hkn55/Kriko-/Hakan Aktaş 18065037 ScrewJackDesignnew.pdf

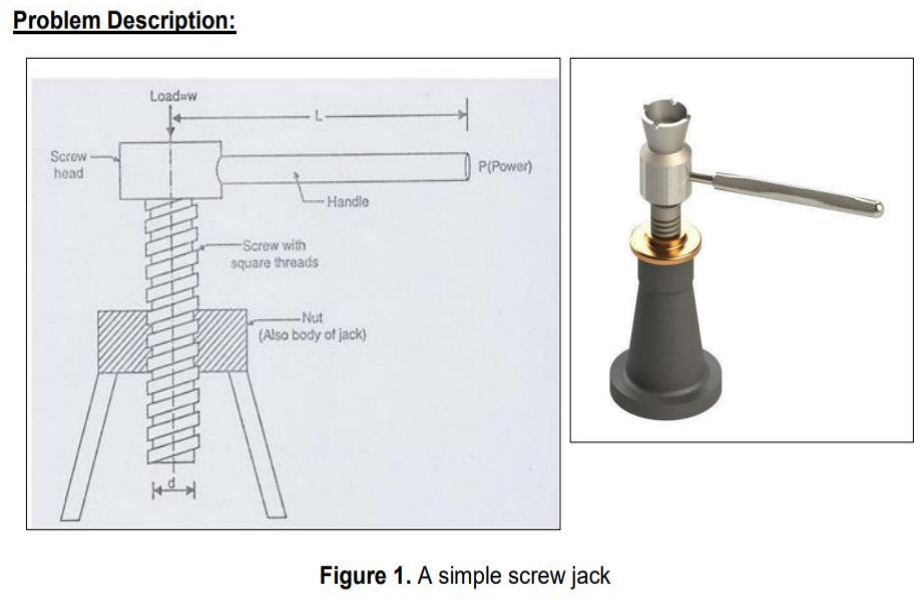
[picture p1: figure]

1-Definition and Mission of Screwjack

Screwjack: a screw-operated jack for lifting, exerting pressure, or adjusting position (as of a machine part).

Even by looking the definition we can figure out the mission of the screwjack.We are using screwjack in order to lift or adjusting the position of any kind of object has.So how this happens ?

The force which we imply on the handle creates a moment and by contribution of this moment a rotating motion occurs.For now these are the general knowledgements that we have to know about screwjack.

2-Assumptions and Values

S = Safety Factor = 2.5 ,

∅ = angle caused by friction between the nut and screw

μs = friction coefficitient between nut and screw = 0.15

tan−1
(us

) = ∅ ≅ 8.5308° ,

p = pitch of screw thread = 3mm
α = helix angle of screw(degree) α = tan−1 (

ρ
πdm

) , dm = (dc+d0)/2 ,

*Lead and pitch for two screw threads; one with one start and one with two starts.
Lead and pitch are closely related concepts. They can be confused because they are the same for most screws. Lead is the distance along the screw’s axis that is covered by one complete rotation of the screw (360°). Pitch is the distance from the crest of one thread to the next. Because the vast majority of screw threadforms are single-start threadforms, their lead and pitch are the same. Single-start means that there is only one “ridge” wrapped around the cylinder of the screw’s body. Each time that the screw’s body rotates one turn (360°), it has advanced axially by the width of one ridge. “Double-start” means that there are two “ridges” wrapped around the cylinder of the screw’s body. Each time that the screw’s body rotates one turn (360°), it has advanced axially by the width of two ridges.

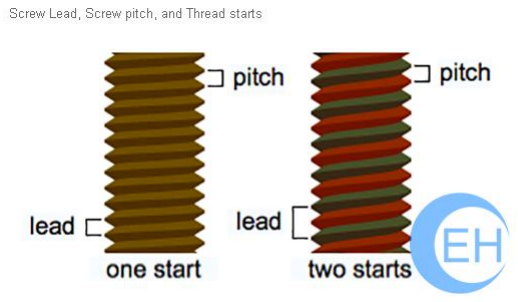
[picture p2: figure]

T1 = Torque required to rotate the screw = W tan(∅ + α)

dm
2

dc = core diameter of screw → d0 = outer diameter of screw = dc + p

W = longitudinal force = (1 + 8) ∗ 1000 = 9000 N

The screw part is made of St 60-2 steel , the nut part is made of St 50-2 steel and the handle is made of St 44-2 steel (Because screw is the most important material for this system.As for other parts it is assumed that they are made of St 37-2 material.

*We will assume that limits for tensile and compression stresses are equal.And also we will not modify yield stresses because we're assuming that diameters are small enough.

*Our analysis about safety of screwjack is terminated.This system is theoretically safe but it’s significant that to consider when it comes manufacturing there are some standarts that we have to obey.Since these materials are not standart elements i have disregarded the manufacturing standarts in this project.

3-Design of Screw

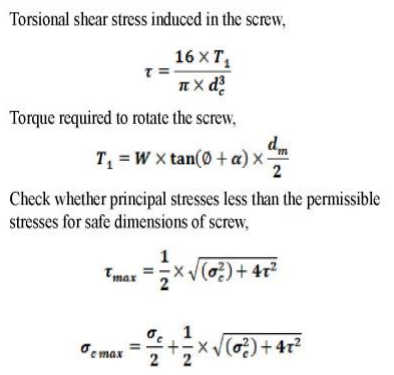
[picture p3: figure]
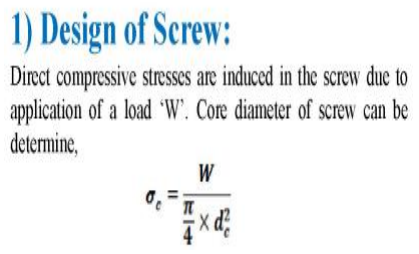
[picture p4: figure]

Befor

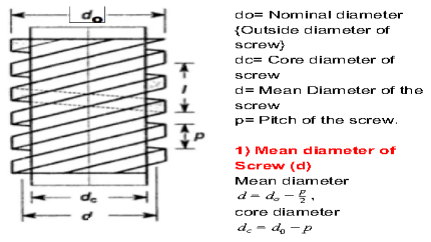
[picture p5: figure]

e doing the calculations firstly we have to devise our method about appropriate safety calculations.So for the inside part of screw we have 3 conditions:

1-Maximum shear stress , 2-Maximum tensile stress , 3-Analytical Method

We will start from analytical method and get a safe core diameter value.

(it's essential to start from the analytical method.First we have to determine safe core diameter variable according to the analytical method then test it for maximum stress theories.Let's start it.)

N/mm^2

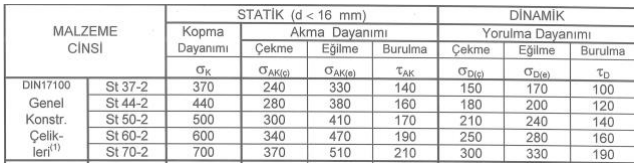
[picture p6: figure]

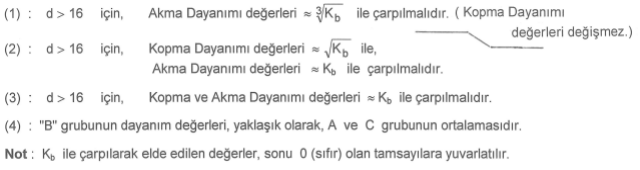
[picture p7: figure]
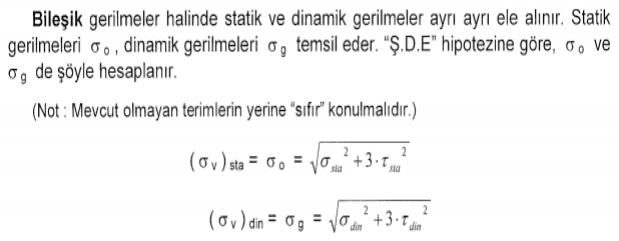
[picture p8: figure]

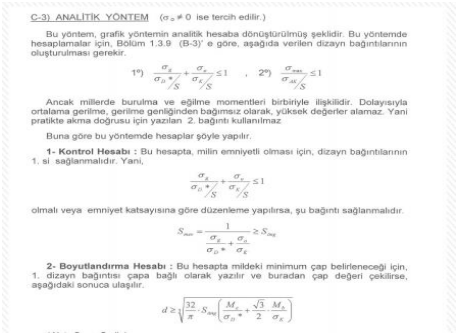
[picture p9: figure]

We don't need to modify the fracture stress.Because our material is in group 1.And since all stresses are static stresses we don't have to calculate σD

∗

Because that part of the equation will be equal to 0.
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
≤ 1 When we simplify this formula as a function of core

diameter we get

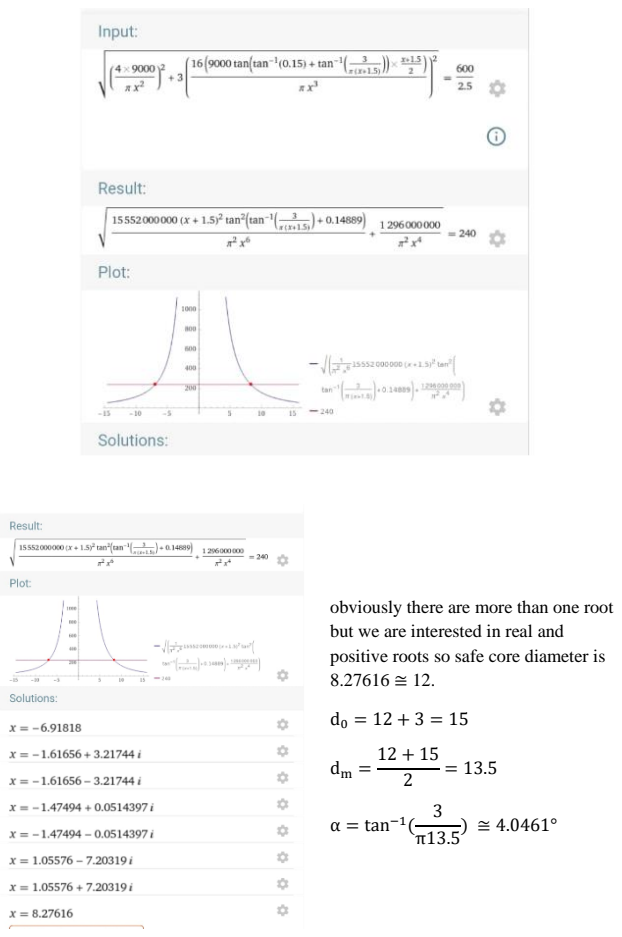
[picture p10: page 7]
α = tan−1

obviously there are more than one root
but we are interested in real and
positive roots so safe core diameter is

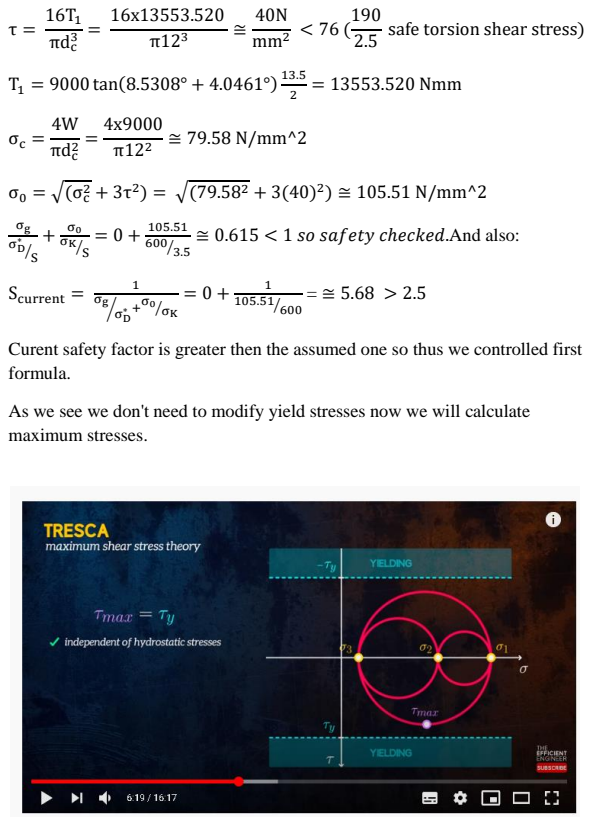
[picture p11: page 8]
safe torsion shear stress); T1 = 9000 tan(8.5308° + 4.0461°); = 13553.520 Nmm; ≅ 0.615 < 1 so safety cℎecked.And also:; Scurrent =

Curent safety factor is greater then the assumed one so thus we controlled first
formula.

As we see we don't need to modify yield stresses now we will calculate
maximum stresses.

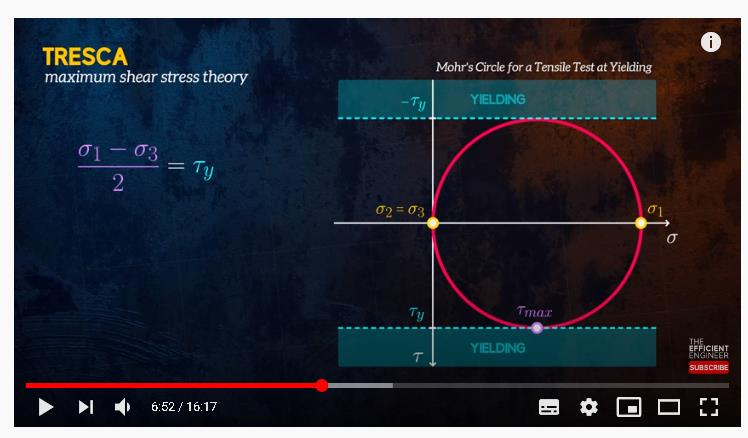
[picture p12: figure]

Tensile yield stress from the material table is represented as sigma1 in this example.And the yield shear stress equals to half of this value.(sigma2 and sigma 3 = 0. )

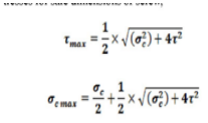
[picture p13: figure]

τmax = 0.5x√(79.582 + 4x402
) ≅ 56.42N/mm^2

σmax =

79.58
2

+ 0.5x√(79.582 + 4x402
)

≅ 96.21N/mm^2

now we will compare these maximum stresses with the yield stresses.

σtensileyield
S

=

340
2.5

= 136 > 96.21 safe

τyield
S

=

340
2x2.5

= 68 > 56.42 safe

4-Design of Nut

This part is a little bit confusing.We will try to understand stresses by using figures.

First let's start with bearing stress.Outside of screw and inside of nut are pressing each other during the load.So this situation creates a stress and it is called as bearing stress.

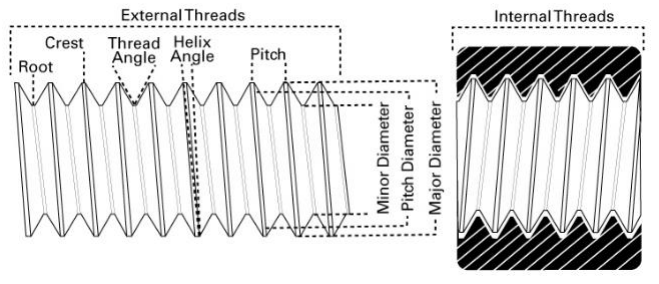
[picture p14: figure]

white trimmed black part is nut.In every single pitch screw is applying a pressure on that nut part.And the circumferance of the same part occurs a shear stress on the lateral area of nut.

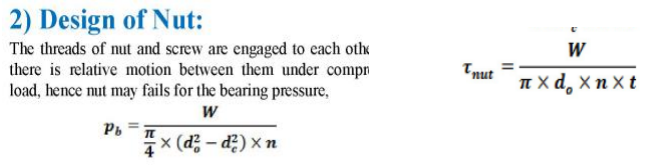
[picture p15: figure]

pb =

9000x4
π(152 − 122)n

, τnut =

9000
π15n1.5

n = number of threads engaged with the nut.Now we will execute the same maximum stresses principle.

t = thickness of screw = p/2

pb =

9000x4
π(152−122)n

≤

300
2.5

→ n ≥ 1.179 , τnut =

9000
π15n1.5

≤

300
2.5x2

→ n ≥ 2.12

*Material is subjected to these stresses separately

it seems that to take n as 5 is a proper choice for us.

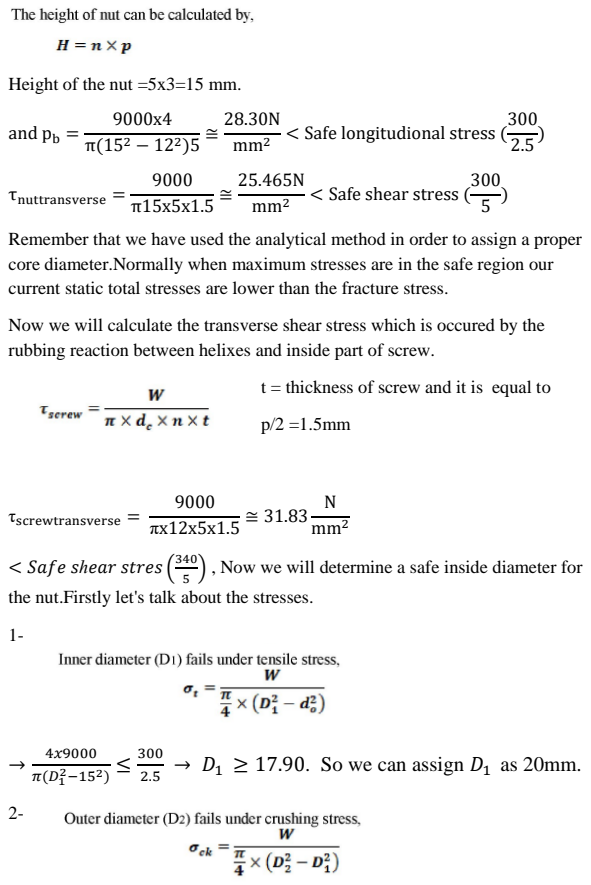
[picture p16: page 11]
and pb =; τnuttransverse =; < Safe shear stress (; τscrewtransverse =

Height of the nut =5x3=15 mm.

mm2 < Safe longitudional stress (

Remember that we have used the analytical method in order to assign a proper
core diameter.Normally when maximum stresses are in the safe region our
current static total stresses are lower than the fracture stress.

Now we will calculate the transverse shear stress which is occured by the
rubbing reaction between helixes and inside part of screw.

t = thickness of screw and it is equal to

< Safe sℎear stres (

) , Now we will determine a safe inside diameter for

the nut.Firstly let's talk about the stresses.

→ D1 ≥ 17.90. So we can assign D1 as 20mm.

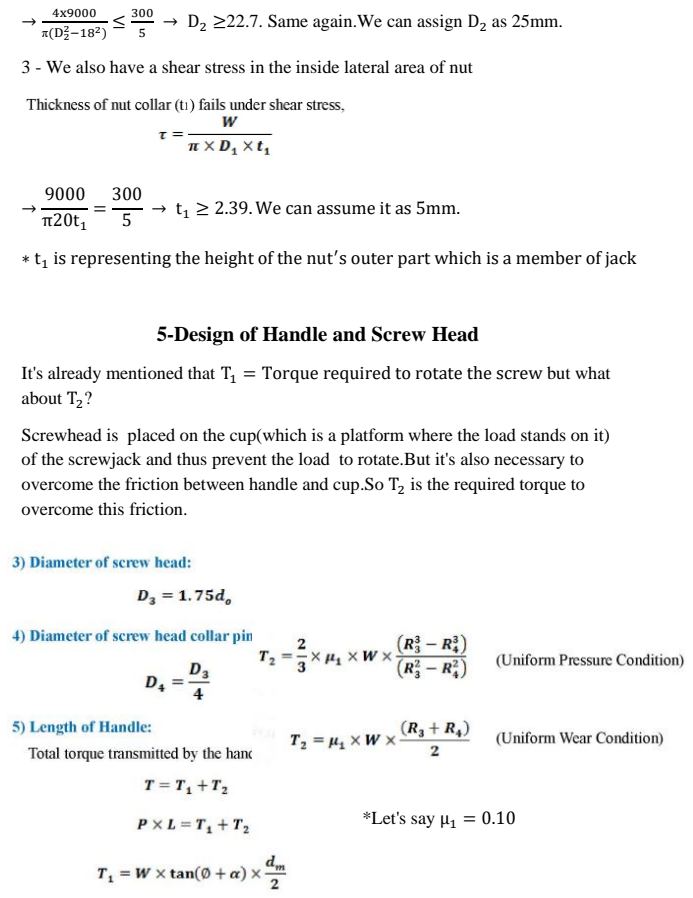
[picture p17: page 12]
*Let's say μ1 = 0.10

→ D2 ≥22.7. Same again.We can assign D2 as 25mm.

3 - We also have a shear stress in the inside lateral area of nut

→ t1 ≥ 2.39. We can assume it as 5mm.

∗ t1 is representing the height of the nut′

s outer part which is a member of jack

5-Design of Handle and Screw Head

It's already mentioned that T1 = Torque required to rotate the screw but what
about T2?

Screwhead is placed on the cup(which is a platform where the load stands on it)
of the screwjack and thus prevent the load to rotate.But it's also necessary to
overcome the friction between handle and cup.So T2 is the required torque to
overcome this friction.

D3 = 1.75x15 = 26.25mm ,D4 =

26.25
4

= 6.5625mm

Mean radius R = ((26.25/2)

3 − (6.5625/2)

3
/((26.25/2)

2 − (6.5625/2)

2

= 13.78125 mm

D3 assumed as 28mm and D4 assumed as 8mm.

T2 = 0.10X9000((26.25/2)

3 − (6.5625/2)

3
)/((26.25/2)

2 − (6.5625/2)

2
)

T2 = 12403.125 Nmm → Ttotal = 12403.125 + 13553.520

= 25956.645 Nmm

At this part we have to reconsider screw and determine the P and handle force F respectively.

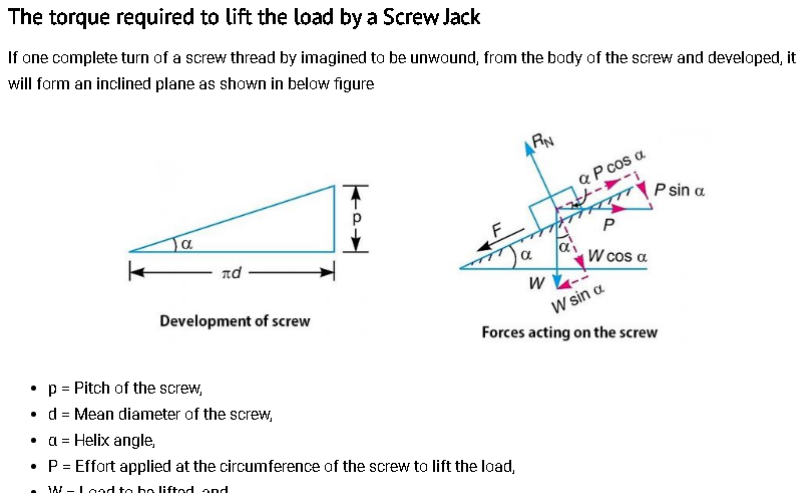
[picture p18: figure]
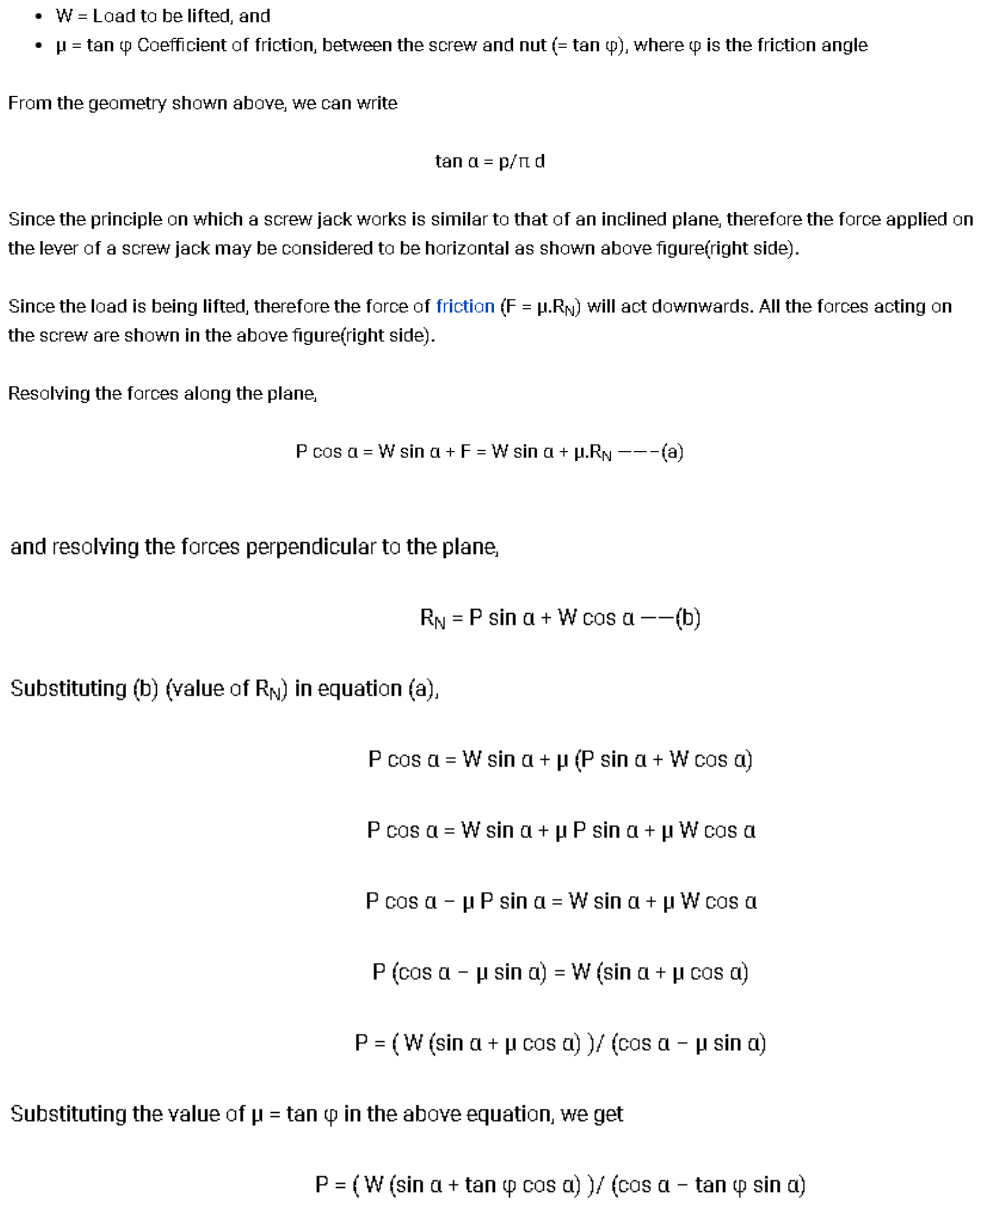
[picture p19: page 14]

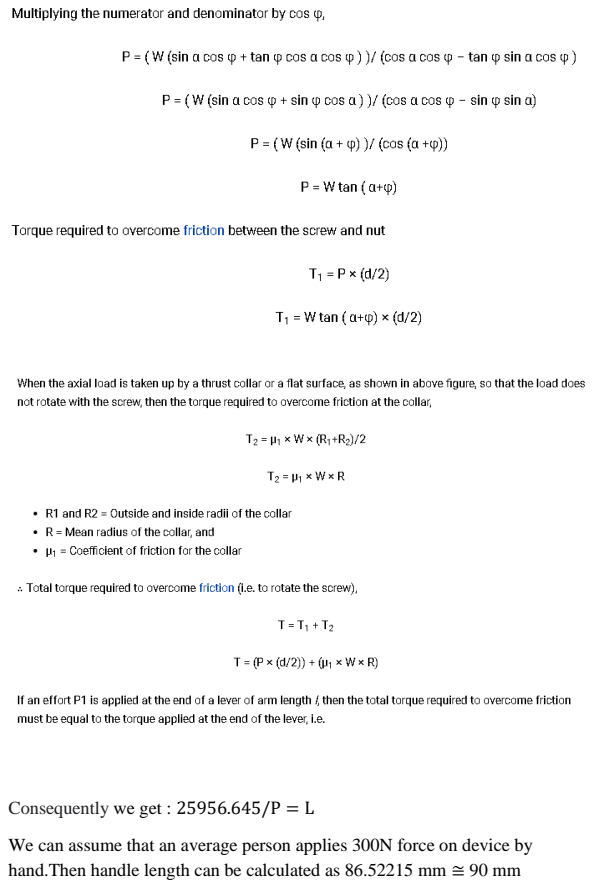
[picture p20: page 15]

Consequently we get : 25956.645/P = L

We can assume that an average person applies 300N force on device by
hand.Then handle length can be calculated as 86.52215 mm ≅ 90 mm

→ (

32x25956.645
π380
2.5

)

(

1/3) ≤ DH ≥ 12.06 we can assume it as 13mm .

then handle diameter can be determined as 15mm.( Just like we have done before bending yield stress value have been taken from the table above.)

*D refers to 2xmean radius

H = 4x13.78125 = 55.125 ≅ 56 mm

6-Controling the Buckling of Screw

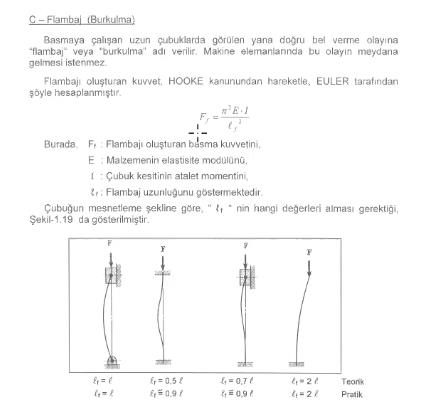
[picture p21: figure]

I = Inertia moment of screw section =

πx124
64

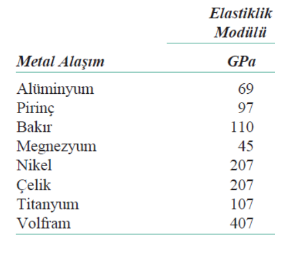
[picture p22: figure]

≅ 1.018 mm4

E = Elasticity Modulus , can be assumed as 207GPa for steel materials.

L = Total height of screw , l

f = effective height of screw

l

f ≤ (

20700x124
xπ

3
64x9000 | )
| 0.5
→ l

f ≤ 480.68 mm

l

f = 0.9 L , L ≤ 534.1 mm we can assume it as 380 mm

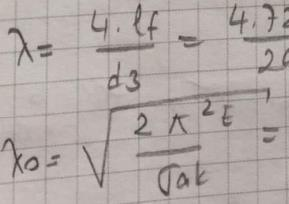
[picture p23: figure]

Now we will compare fragility values

σy = yield stress of St 60 − 2 = 340N/mm^2

λ = ((4x380x9)/(10x12)) = 114

λ0 = (

2xπ

2207000
340 ) 0.5 ≅ 109.62

Since λ > λ0 buckling is under control.

*Our analysis about safety of screwjack is terminated.This system is theoretically safe but it’s significant that to consider when it comes manufacturing there are some standarts that we have to obey.Since these materials are not standart elements i have disregarded the manufacturing standarts in this project.

Now we will draw technical drawing of screwjack and it’s members.But before the drawings i want to share my references.

### References

https://www.slideshare.net/vishalmuttagihttps://www.scribd.com/user/298314544/Naw-Az

https://www.youtube.com/channel/UC1IWvLevB3dA8rC0X3y_emw

https://www.youtube.com/channel/UCVLbzhxVTiTLiVKeGV7WEBg

https://www.youtube.com/channel/UCltVEZ6GecWntoZ19FvaWhQ

https://www.youtube.com/channel/UCiGxYawhEp4QyFcX0R60YdQ

https://www.youtube.com/watch?v=xkbQnBAOFEg

https://www.parktool.com/blog/repair-help/basic-thread-concepts

everhardwarestore.com/screw-pitch-different-lead-pitch.html

https://extrudesign.com/calculate-the-torque-required-to-lift-the-load-by-a-screw-jack/

https://www.humbarahane.com/elastisite-moduluyoung-modulu-ve-hooke-kanunu/

https://www.youtube.com/watch?v=GfbcxJmjn9s

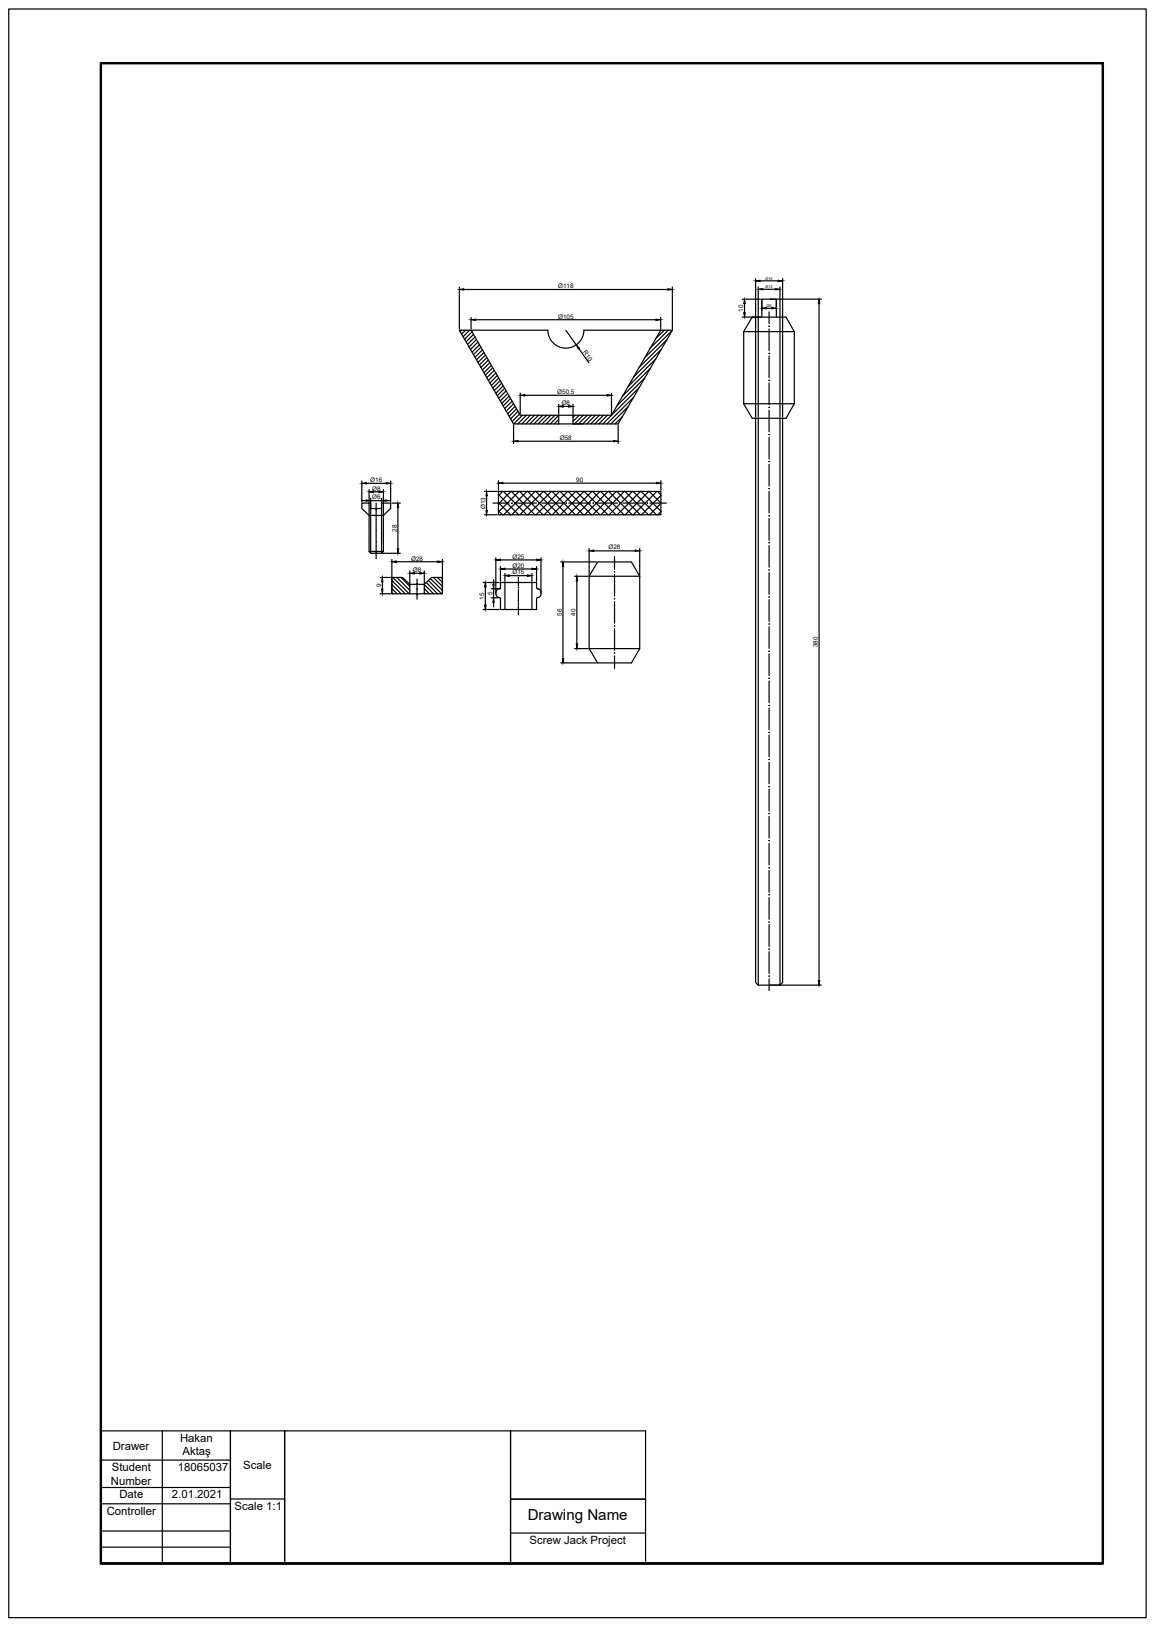
[picture p24: page 19]

Drawer | Hakan Aktaş | Scale

Student Number | 18065037

Date | 2.01.2021
Controller

Scale 1:1 | Drawing Name

Screw Jack Project

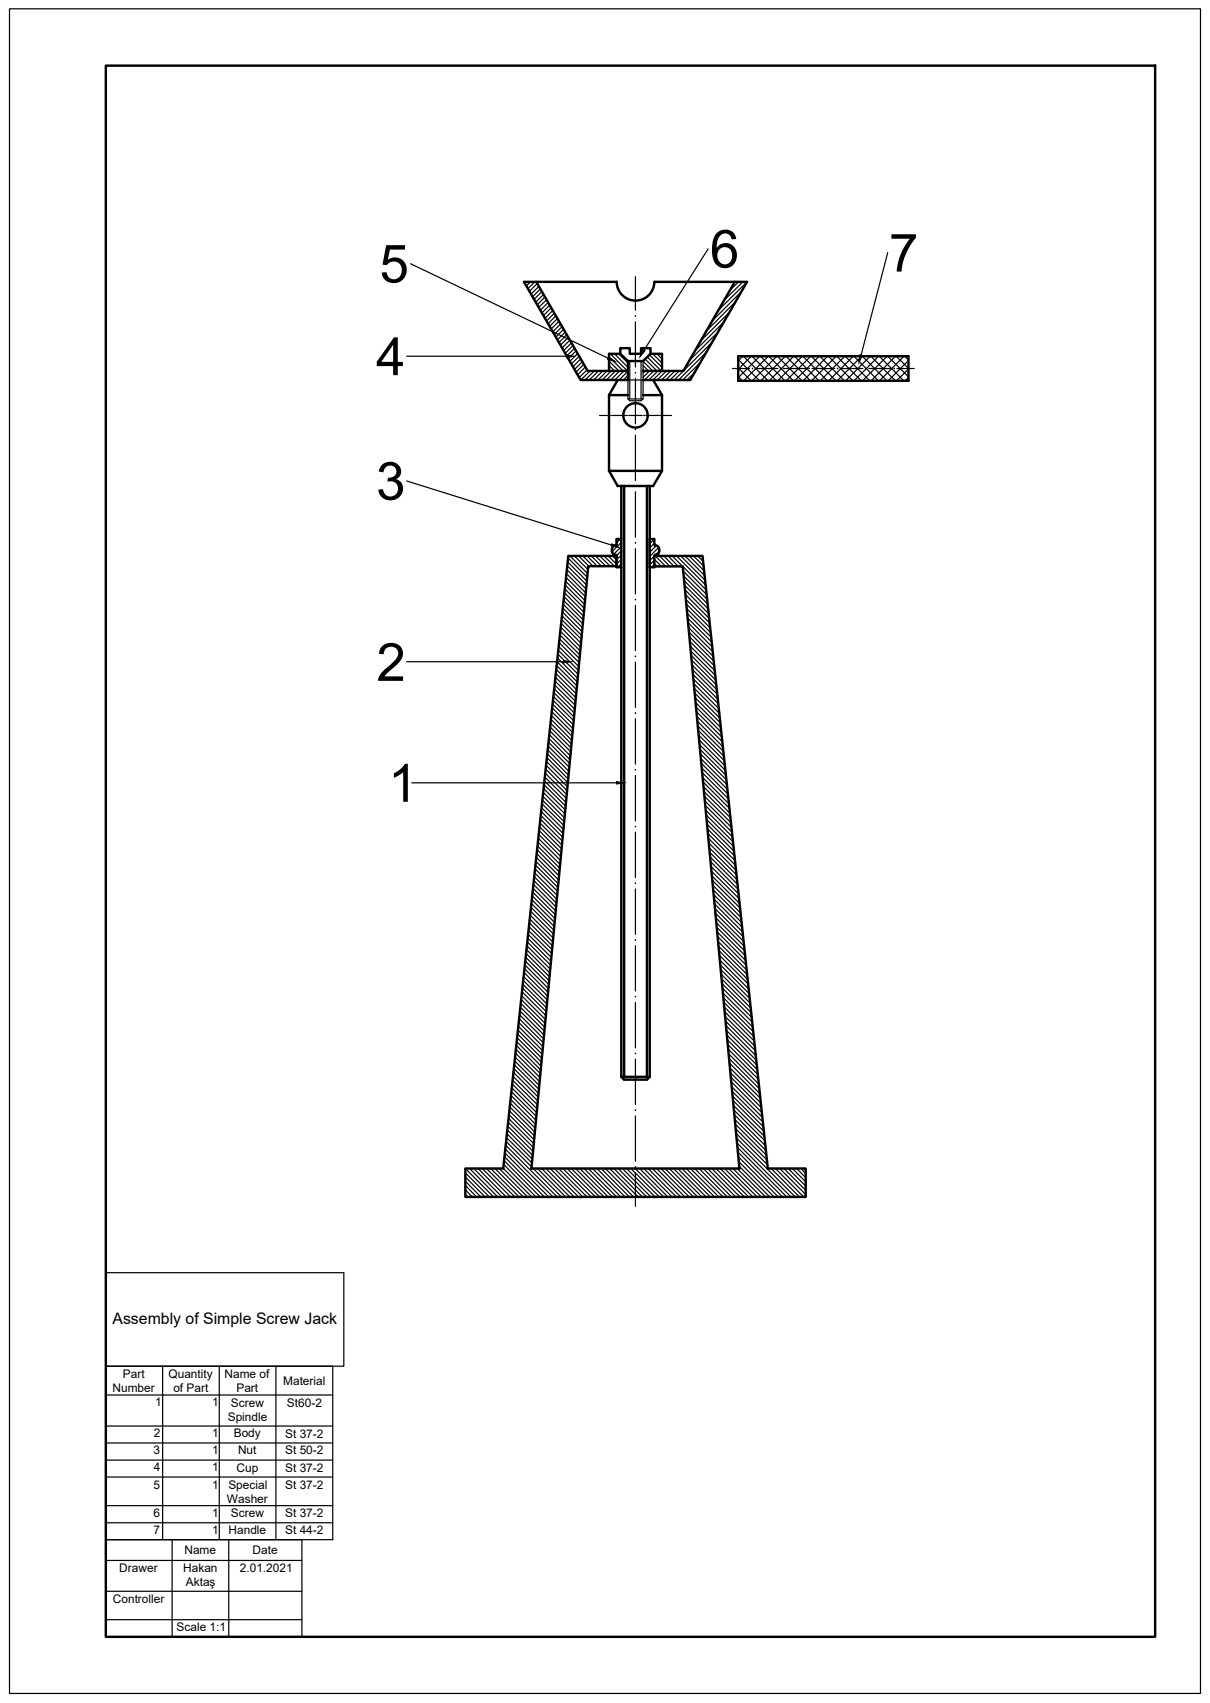
[picture p25: page 20]

Assembly of Simple Screw Jack

Part Number | Quantity of Part | Name of Part | Material

1 | 1 | Screw Spindle | St60-2

2 | 1 | Body | St 37-2
3 | 1 | Nut | St 50-2
4 | 1 | Cup | St 37-2
5 | 1 | Special Washer | St 37-2

6 | 1 | Screw | St 37-2
7 | 1 | Handle | St 44-2
Name | Date

Drawer | Hakan Aktaş | 2.01.2021

Controller

Scale 1:1
