hkn55/Kriko-/18065037_PRJ_1.pdf.pdf

YILDIZ TEKNİK ÜNİVERSİTESİ

MAKİNE MÜHENDİSLİĞİ BÖLÜMÜ

MAKİNE MÜHENDİSLİĞİ PROJE 1

Disiplinler Arası Proje Öğrencileri: 18065003 İBRAHİM HAKKI SUSUZ (MAK) 18065037 HAKAN AKTAŞ (MAK) 18065059 ELİF SOYSAL (MAK) 18061003 MURAT YOLALAN (END) 18061004 CANDAŞ SAİT ŞAHİN (END)

Disiplinler Arası Danışman Öğretim Üyeleri

Doç. Dr. Mehmet BOZCA
Dr.Öğr.Üyesi Hayri BARAÇLI

İSTANBUL

2021

## VİDALI KRİKO TASARIMI

i

İÇİNDEKİLER

2.4 Makas Kriko Tasarımı Ve Kullanımında Dikkat Edilmesi Gereken Hususlar........ 6

### 3.2. Kriko Kollarının Burkulma Hesaplarına Göre Geometrilerinin Belirlenmesi ... 9

Şekil Listesi

### 1. GİRİŞ

Vidalı kriko, bir arabayı kaldırmak ve belirli bir yükseklikte tutmak için kullanılan, elle çalıştırılan bir alettir. Krikoların gelişimi, 1851’de Richard Dudgeon’ın ilk hidrolik krikoyu icatıyla başlamıştır[1]. Günümüzde yeni arabalın çoğuna standart donanım olarak dahil edilir [2]. Bu proje kapsamında, kaldırılması gereken kuvveti karşılayabilecek bir krikonun civata ve kollarının tasarımını yapmak amaçlanmaktadır.

Krikonun Çalışması

Kirkonun çalışması cıvatanın döndürülmesi ile başlar. Civatanın döndürülmesi ise bijon anahtarı ile sağlanır. Cıvata, ilerleme yönünde döndürülünce, kriko pimleri arasındaki kriko açıklığı azalır ve yük kaldırılmaya başlanır. Krikonun bası kuvveti, cıvatanın uyguladığı çekme kuvveti ile elde edilir. Tam tersi hareket ile de kriko açıklığı azalarak yük alçalır. Krikoda hereket civatası, dişli mekanizması görevi görür. [3] [4]

Kriko Parçaları

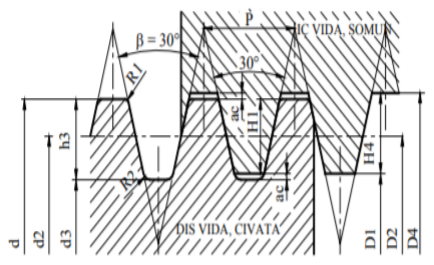
[picture p26: figure]

Hareket cıvatası, sabitlenmiş iki somun, bu somunlara bağlı dört kol, altı pim ve alt ve üst yataklardan oluşur.

Hareket Civatası: Trapez vida kullanılır. Trapez vidalarda diş biçimi kesik üçgendir bu da boşluksuz bir hareket iletimi ve gerekli olursa çözülebilen bir bağlantı sağlar. Dörtköşe vidalara göre daha büyük kuvvet taşır. Diş profili 30o
dir. TS 61-23 ve DIN 103 standartlarına göre üretilirler. [5]

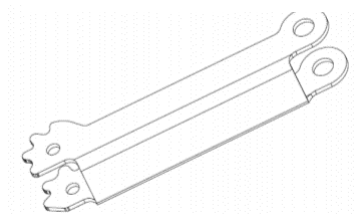
[picture p27: figure]

Kriko Kolları: İki taraf arasındaki yükü dengelemek için ideal bağlantılara sahip olmalıdırlar. Kollar bası gerilmesine ve burkulmaya maruz kalır. Bu nedenle akma dayanımı yüksek malzemeden yapılmalıdır. Kolun bir ucundaki diş profili kuvvet ve hareket aktrımını sağlar. [2]

### 1.1. Projenin Amacı

Ağır yüklerin kaldırılması yüzyıllar boyunca insanlar için büyük bir problem olarak görülmüştür. Zaman geçtikçe, kaldıraç, çıkrık gibi sistemler kullanılarak bu problemin üstesinden gelinmeye çalışılmıştır. Bizim üreteceğimiz kriko da kaldıraç ilkesine dayalı olarak kremayer-pinyon mekanizması (vida sistemi) uyarınca çalışarak ve sıradan bir insanın normal gücüyle çok büyük ağırlıkları kısa mesafelerde kolayca kaldırılmasını sağlayıp düşük kuvvetlerle büyük ağırlıkların kaldırılması probleminin üstesinden gelmektedir.

1.2.Problem Tanımı

Şekil 1.1 Trapez Vida Profili

Şekil 1.2 Kriko Kolları

Bu projede irdelediğimiz çözüm günlük hayata şu şekilde indirgenebilir: Bir işletmede ısıtıcı olarak kullanılan suyun, ısı alışverişinin ardından 1 litrelik bir kapta depolandığını varsayalım.Atık su kabı doldurduktan sonra kriko yardımıyla kabı yükseltip başka bir makine parçası tarafından taşınması için iletebiliriz. Bu şekilde atık su tekrar kullanılabilir.

1.3.Proje Planlaması

Projemizde, 1000N’lık yükü taşıyabilecek bir krikonun hareketli cıvatasının boyutlandırılması ve burkulmaya maruz kalan kriko kollarının flambaj hesaplarına göre kontrolü yapılarak geometrileri belirlenecektir. Belirlenen geometri ve malzemelere göre parçaların imalat resmi ve toplu montaj resmi Solidworks ile çizilecektir. Son aşamada, seçilen malzeme ve parçalara göre krikonun maliyeti hesaplanacaktır.

a) Hareketli cıvata çapının boyutlandırılması: Cıvata, bağladığı parçalar arasında hem şekil hem kuvvet bağı oluşturur. Dairesel hareketi doğrusal harekete, momenti doğrusal kuvvete çevirmeyi sağlar. Cıvata bağlantıları sağlanırken oluşan kuvvet, parçaları birbiri üzerine bastırır ve cıvatayı da kendi ekseni doğrultusunda çekmeye zorlar. Anahtara kol kuvveti ile uygulanan Moment (Ma), sistemdeki cıvata-somun dişleri arasındaki sürtünme momentini (M1) ve somun ile sıkılan parça arasında oluşan “başlık altı” sürtünme momentlerinin(M2) toplamını sağlamak zorundadır. Statik halde sıkılan cıvatanın mukavemet hesaplarında cıvata-somun dişleri arasındaki sürtünme momenti hesaba katılmaz. Bu durumda projemizde burulma gerilmesi hesaplanırken sadece M1 momenti dikkate alınacaktır. Civatanın çapının boyutlandırılması için, öncelikle çelik uygun bir cıvata malzemesi seçilecektir. Seçtiğimiz malzemenin akma dayanımı değerleri tablolardan alınıp, uygun emniyet gerilmesi değeri bulunacaktır. Diş dibi kesitine gelen çeki gerilmesi ve burulma gerilmesi, makine elemanlarının gerilme formülleri yardımıyla bulunacaktır. Civatanın emniyetli olması için eşdeğer gerilmenin, seçilen malzemenin emniyetli gerilmesinden küçük olması gerekmektedir. [6]
b) Kriko kollarının burkulma hesaplarına göre geometrilerinin belirlenmesi: Kriko kolları, sağ ve sol taraflardaki yükü dengelemelidir. Kollar C biçimindedirler. Kollar, basma kuvvetinden dolayı bası gerilmesine ve burkulmaya maruz kalmaktadır. Projemiz kapsamında burkulma(flambaj) hesabı yapmamız gerekmektedir. Cıvata hesabı ile benzer şekilde önce bir malzeme seçimi ve emniyetli değerin seçimi yapılacaktır. Seçilen malzemenin akma dayanımı yüksek olmalıdır. Euler denklemine göre, diğer parametrelerin de hesaplanmasıyla basma gerilmesi hesaplanacak ve karşılaştırılmalar yapılarak kolların geometrileri belirlenecektir. [2] [7]
c) Krikonun montaj resminin çizilmesi: Solidworks veya Autocad ile çizim yapılacaktır. Çizimin ön ve sol görünüşü antetli kağıda yerleştirilecek ve parça listesi seçilen malzemelere göre oluşturulacaktır.
d) Krikonun parçalarının imalat resimlerinin çizilmesi: Montaj için çizilen parçalar uygun antetli kağıtlara yeterli sayıda görünüşler (üst, ön, sağ) ile yerleştirilecektir. Parçanın boyutları, malzemeleri, tolerans ve yüzey kaliteleri için uygun değerler araştırılıp teknik resme eklenecektir.

e) Krikonun maliyet hesaplamasının yapılması: Seçilen malzemelere ve geometrilere göre, kriko kollarının ve cıvatanın maliyet hesabı yapılacaktır. Uygun parçalar maliyetinin uygunluğuna göre imal edilecek ya da hazır olarak temin edilecektir. Parça imal edilecek, ise tablodan “esas işleme zamanı” hesaplanıp %100 alınarak “imalat zamanı” ve buradan da işçilik maliyeti hesaplanabilir. [8]

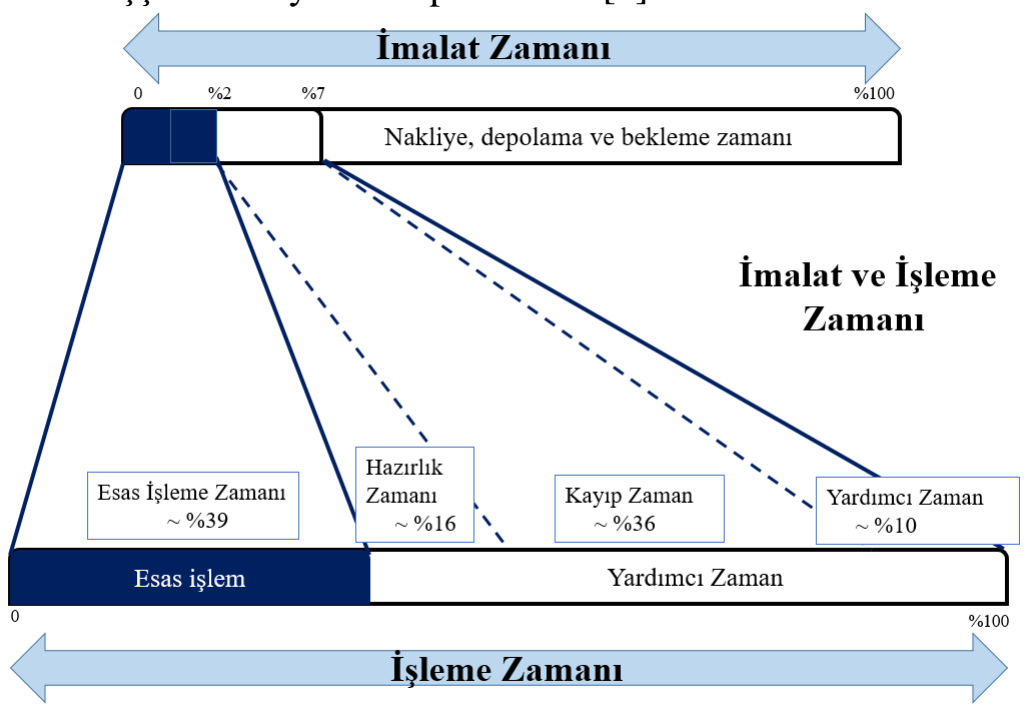
[picture p28: figure]

SÜREÇ YÖNETİMİ ARAŞTIRMA ÇIKTILARIMIZ

Tasarım, modelleme, yürütme, izleme ve optimizasyon döngüsü takip edilerek iş süreci yönetimi gerçekleştirilir. Süreç amacımıza uygun olarak optimize edilmiş olur. Literatür araştırmasından çıkarımlarımıza göre bu döngüye bağlı kalarak iş süreçlerini yönetmeyi planlıyoruz. Tasarım değişkenlere bağlı modelimizi yürüttükten sonra (bu aşamayı hayali olarak gerçekleştireceğiz) izleme için makine öğrenmesi algoritmaları kullanmayı planlıyoruz. Daha sonra izleme sürecinden çıktılarımızla gerekli optimizasyonları yapmayı planlıyoruz.

### 2. LİTERATÜR ARAŞTIRMASI

### 2.1 Vidalı Krikonun Tarihçesi

MÖ. 200’de Arşimet, temelinde bir silindirin etrafına sarılan eğimli bir düzlem olan bir vidayı makine elemanı olarak kullanmanın işlevselliğini su pompalamak için kullandığı bir icadı ile ilk kez gösterdi. Antik Roma döneminden kalıntılarda da vidanın kullanıldığına dair kanıtlar var, ancak yükleri kaldırmak için vidalı bir kriko kullanımını ilk kez 1400'lerin sonlarında gösteren kişi Leonardo Da Vinci’dir. Da Vinci’nin tasarımı, yükü hareket ettirmek için yataklar üzerinde desteklenen bir sonsuz dişlinin döndürmesiyle dişliye bağlı bir vidayı döndürerek vida üzerindeki yükü kaldırma prensibine dayanmaktaydı.

18. ve 19. yüzyılın sonlarındaki sanayi devrimi ile, John Wilkinson ve Henry Maudsley gibi İngiliz mucitler aracılığıyla takım tezgahlarında vidanın ilk kullanımları

Şekil 1.3 İmalat Zamanı tanıtıldı. 18. yüzyılda yaşayan makine mühendisliğinin önemli mucitlerinden Whitworth’ün vida kesme makineleri, hassas ölçüm cihazları ve vida dişlerinin açısını ve aralığını kapsayan standart çalışmaları bugün endüstrimizde vida kullanımının temelini attı. 1880'lerin başlarında Frank Henry Sleeper bir kaldırma krikosu tasarladı. Bu tasarım Da Vinci'nin tasarımlarımı temel almaktaydı, çünkü bir yükü desteklemek için bilyalı yatağın ve yükün hareket ettirilmesi için dişliler ve bir vida aracılığıyla dönme hareketinin doğrusal harekete aktarılması ilkesine dayanıyordu. Cihaz verimli, güvenilir ve kullanımı kolaydı. Çoğunlukla lokomotifleri ve vagonları kaldırmak amacıyla demiryolu endüstrisi tarafından kullanıldı. Günümüzde de gelişen malzeme bilimi ve seri üretim teknikleri ile vida temelli kriko türleri kolay ulaşılabilen, ucuz, güvenli ve dayanıklı yük kaldıraçları olarak yaygın olarak kullanılmaktadır.

### 2.2 Vidalı Krikonun Kullanım Alanı

Otomobillerin tamir ve bakımında, genellikle bir lastiği değiştirmek veya otomobilin alt tarafına erişmek için bir otomobilin kaldırılması gerekir. Bu sebeple, bir otomobili zemin yüzeyinden kaldırmak için çeşitli krikolar geliştirilmiştir.

### 2.3 Günümüzde Kullanılan Kriko Çeşitleri

### 2.3.1 Makas Kriko

Makas krikolar mekanik cihazlardır ve 1930'lardan beri kullanılmaktadır. Makas kriko, bir aracı onarım için kaldırmak üzere bir makas gibi çapraz tarama mekanizmasıyla yapılmış bir cihazdır. Tipik olarak dikey bir şekilde çalışır. Kriko, yükü hareket ettirmek için çapraz kollar boyunca alt desteklere basınç uygulayarak açılır ve katlanır. Makas krikolar, kısa mesafelerde büyük yükleri taşımak için kullanılan basit mekanizmalardır. Çoğu makaslı kriko, bir güç vidası ile tahrik edilen dört ana elemandan oluşan tasarıma sahiptir. Makas kriko, makas krikosunun bir ucuna yerleştirilen küçük bir krank döndürülerek çalıştırılır. Bu krank genellikle "Z" şeklindedir. Krank, makaslı kriko üzerindeki kuvvet nesnesi olan vidanın ucuna monte edilmiş bir halka deliğine oturur. Bu krank döndürüldüğünde vida döner ve bu da krikoyu yükseltir. [9]

### 2.3.2 Vidalı Kriko

Vidalı Kriko, temel olarak bir vida, bir somun, baskı yatakları ve bir gövdeden oluşur. Kriko, somun sabitlenip vida döndürülerek veya somun döndürülerek vidanın dönmesi engellenerek çalışabilir. Vidanın üstüne sabit bir platform takılmıştır. Bu platform, yük için bir destek görevi görür ve ayrıca yükün kaldırılmasına veya indirilmesine yardımcı olur. Bu krikolar, makas krikolardan daha sağlamdır ve daha ağır yükleri kaldırabilir. Bir vidalı krikoda piston dikeydir ve kaldırılan nesneye temas eden bir yatak parçasını doğrudan destekler. Krikonun tamamen açılmış hali kapalı halinin 2 katı yüksekliğine kadar ulaşır. Bu tabanı yüksek araçlarda kullanımı kolaylaştırır. [10]

### 2.3.3 Hidrolik Kriko

Bir hidrolik kriko, sıkıştırılamayan bir sıvı kullanır. Kendinden yağlamalı ve stabil olduğu için yağ kullanılır. Piston geri çekildiğinde, bir emme çek valfi vasıtasıyla rezervuardan pompa odasına yağ çeker. Piston ileri hareket ettiğinde, yağı bir tahliye çek valfinden silindire iter. Emiş valfi bilyası haznenin içindedir ve pistonun her çekilmesiyle açılır. Tahliye valfi bilyası haznenin dışındadır ve yağ silindire itildiğinde açılır. Bu noktada, hazne içindeki emme bilyesi kapanmaya zorlanır ve silindirde yağ basıncı oluşur. Hidrolik krikolar, araçla birlikte taşınacak bir acil durum krikosu yerine genellikle atölye çalışması için kullanılır. Belirli bir araç için tasarlanmamış bu krikoların kullanımı, zemin koşullarının, araç üzerindeki kriko noktasının seçilmesinde ve kriko uzatıldığında dengenin sağlanmasında olağan özenden daha fazlasını gerektirir. [11]

### 2.4 Makas Kriko Tasarımı Ve Kullanımında Dikkat Edilmesi Gereken Hususlar

1. Düşük yüzey temas basıncı sağlanmalıdır. Vida boyutunu ve somun boyutunu artırmak, aynı çalışma yükü için diş temas basıncını azaltacaktır. Birim basıncı ne kadar yüksek ve yüzey hızı ne kadar yüksekse, aşınma o kadar hızlı olacaktır.
2. Eşleşen yüzeyler iyice yağlanmış halde tutulmalıdır. Yağlama ne kadar iyi olursa, hizmet ömrü de o kadar uzun olur. Güç vidası ve somunu için gres bağlantı parçaları veya diğer yağlama araçları sağlanmalıdır.
3. Eşleşen yüzeyleri temiz tutulmalıdır. Pislik kalıntıları yumuşak somun malzemesine kolayca gömülebilir. Gömülen kalıntılar bir zımpara görevi görecek ve eşleşen vida yüzeyini aşındıracaktır.
4. Isı uzak tutulmalıdır. Eşleşen yüzeyler ısındığında, çok daha yumuşak hale gelirler ve daha kolay aşınırlar. [12]

### 2.5 Süreç Yönetimi Literatür Araştırması

İş süreci yönetimi (BPM), insanların iş süreçlerini keşfetmek, modellemek, analiz etmek, ölçmek, iyileştirmek, optimize etmek ve otomasyona entegre etmek için çeşitli yöntemlerin kullandığı disiplindir. [13] [14] Bir şirketin iş süreçlerini yönetmek için kullanılan yöntemlerin herhangi bir kombinasyonu BPM' kapsamına girer. [15] Süreçler yapılandırılmış ve tekrarlanabilir veya yapılandırılmamış ve değişken olabilir.

Life-Cylce

İş süreci yönetimi etkinlikleri, keyfi olarak tasarım, modelleme, yürütme, izleme ve optimizasyon gibi kategoriler halinde gruplandırılabilir. [16]

Tasarım

Süreç tasarımı, hem mevcut süreçlerin tanımlanmasını hem de "yapılacak" süreçlerin tasarımını kapsar. Odak alanları, süreç akışının temsilini, içindeki faktörleri, uyarıları ve bildirimleri, yükseltmeleri, standart işletim prosedürlerini, hizmet seviyesi sözleşmelerini ve görev devretme mekanizmalarını içerir. Mevcut süreçler dikkate alınsın veya alınmasın, bu adımın amacı doğru ve verimli yeni bir tasarım sağlamaktır.

Modelleme

Modelleme, teorik tasarımın değişkenler üzerinden kombine edilerek sunulmasıdır. (Değişkenlere örnek olarak farklı şartlar verilebilir)

Yürütme

İş süreci yürütme, genel olarak belirlenmiş ve modellenmiş bir iş sürecini hayata geçirmekle ilgilidir. Bir iş sürecini hayata geçirmek, manuel veya otomatik olarak veya manuel ve otomasyon kullanılmış iş görevlerinin bir kombinasyonu ile yapılır. Manuel iş süreçleri insan tarafından yönlendirilir. Otomatikleştirilmiş iş süreçleri yazılım odaklıdır. İş süreci otomasyonu, iş süreçlerini otomatikleştirmek için kullanılan yöntemleri ve yazılımları kapsar.

İzleme

İzleme, bireysel süreçlerin izlenmesini kapsar, böylece durumları hakkındaki bilgiler kolayca görülebilir ve bir veya daha fazla sürecin performansına ilişkin istatistikler sağlanabilir. Bu izlemeye bir örnek, bir müşteri siparişinin durumunu belirleyebilmektir (örneğin, sipariş geldi, teslimat bekleniyor, fatura ödenmiş), böylece işlemindeki sorunlar tespit edilebilir ve düzeltilebilir.

Tahmine Dayalı İş Süreci İzleme, bir iş sürecinin çalışan örneklerinde ne olacağını tahmin etmek için veri madenciliği, makine öğrenimi ve diğer tahmin tekniklerinin uygulanmasıyla ilgilidir ve gelecekteki döngü süresi, uyum sorunları vb. İle ilgili tahminler yapmaya olanak tanır. İş süreci izleme, Destek Vektör Makineleri, [17] Derin Öğrenme yaklaşımları ve Random Forest algoritmalarını içerir.

Optimizasyon

Süreç optimizasyonu, modelleme veya izleme aşamasından süreç performans bilgilerinin alınmasını içerir; potansiyel veya fiili darboğazları ve maliyet tasarrufu veya diğer iyileştirmeler için potansiyel fırsatları belirlemek; ve sonra, bu geliştirmeleri sürecin tasarımında uygulamak optimizasyona girer.

### 3. MÜHENDİSLİK HESAP VE ANALİZLERİ

### 3.1. Hareket Civatasının Boyutlandırılması

Uygulanan kuvvet F=1000N

Kriko açıklığı emin=70mm ve emax=200mm

Kol boyu lkol=150mm

Cıvatayı zorlayan kuvvetlerin bulunması

Kollar, simetriden dolayı birbirine eşit olan F1=F2 kuvvetlerince basıya zorlanır.

Cıvataya her iki uçtan çeki kuvveti Fç etki eder (statik hal).

Maksimum kriko açıklığı, krikoyu su deposunun altına koyabilmek için gereklidir. Krikonun depoyu kaldırmaya başladığı kriko açıklığını 190mm alırız. Geometriden α = 39,29° bulunur.

Cosα =

F/2
F1

=

F/2
F2

→ F1 = F2 =

1000/2
cos (39,29)

= 646,03 N

Sin α =

Fç/2
F1

→ Fç = 2.F1sin α = F.tan α = 818,199 = 818,2 N

Cıvata malzemesi 5.6 kalite St60 malzeme seçildi. 5.6 civata için akma dayanımı tablolardan σAKMA=340 N/mm²
okunur.

σEMNİYET=

σakma
2

= 170 N/mm²

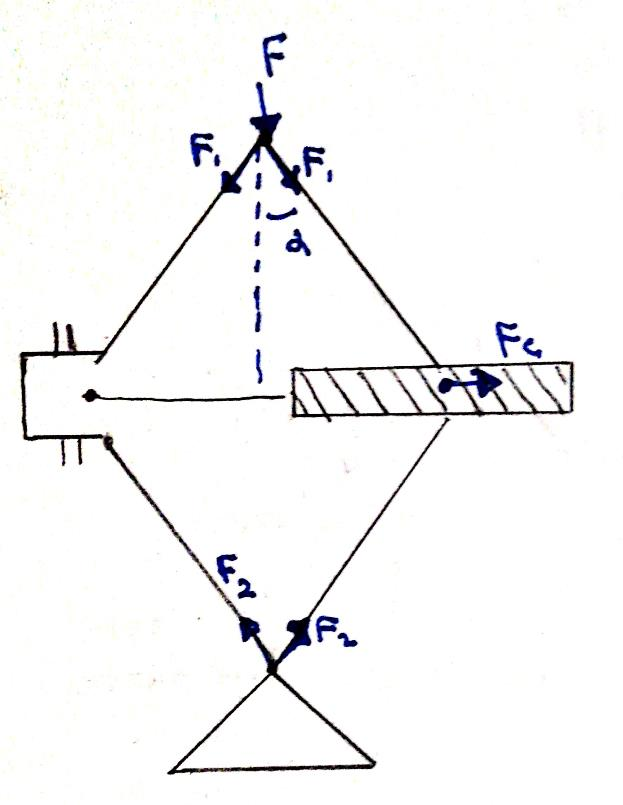
[picture p29: figure]

Cıvata, çeki ve burulmaya zorlanmaktadır. Uygun cıvatayı seçmek için diş dibi çapı (d1) için bir ön hesap yapılacaktır.

σMEVCUT =

1,3.Fç

(π

d1

2
4

)

≤ σEMNİYET

σMEVCUT = σEMNİYET alınırak d1 = √ 4.Fç.(1,3)

π.σemniyet

= √
4.(818,2).(1,3)
π.170 = 2,82 mm bulunur.

d1’e uygun karşılık olarak Tr 12x3 seçildi. Trapez profil vidalarda α = 30°dir.

Anma Çapı x Adım | Ortalama Çap | Diş Dibi Çapı | Diş Dibi Kesiti
d x P(h) | d2 | d1 | A1
Tr 10 x 2 | 7,25 | 6,2 | 30,2
Tr 12 x 3 | 9 | 7,5 | 44,2

Tr 12x3’ün uygun olup olmadığını belirlemek için mukavemet kontrolü yapılır.

Diş Dibi kesitine gelen çeki gerilmesi: σç =

Fç
A1

=

818,2
44,2

= 18,51 N/mm²

Şekil 3.1 Krikoya Uygulanan Kuvvet

Diş Dibi kesitine gelen burulma gerilmesi: τb =

M1
(πd1 | 3 /16)

Burada M1,somun içinde kenetlenen dişler arasındaki sürtünmeyi temsil eder.

M1=Fd2tan (β+ρ

′
)

→ tanβ =

ℎ
πd2

=

2
π.(9)
= 0,0707 → | β | = 36,26°

→tanρ

′=

| | μ | = | 0,12
α cos ( ) | cos (
2

30/2)

= 0,125 → ρ

′ = 7,125°

M1=(818,2).(9).tan(36,26+7,1) = 6953,86 Nmm

| M1 | | = | 6953,86 | = 83,95 N/mm²
τb | | =
(πd1

3
/16)

π(7,5)

3/16

Eşdeğer gerilme: σEŞ =√σç
2 + 3τb

2
= √(27,09)
2 | + 3(83,95)
2 | = √21876,6 =147,90 N/mm²

σEMNİYET=

σakma
2

= 170 N/mm² bulunmuştu. σEŞ < σEMNİYET olduğundan Tr 12x3 emniyetlidir.

### 3.2. Kriko Kollarının Burkulma Hesaplarına Göre Geometrilerinin Belirlenmesi

Her bir kriko koluna gelen bası kuvveti cıvata boyutlandırması esnasında hesaplanmıştı.

Şimdi bu kuvvetlerin kriko kollarında burkulmaya sebebiyet verip vermeyeceği araştırılacaktır.

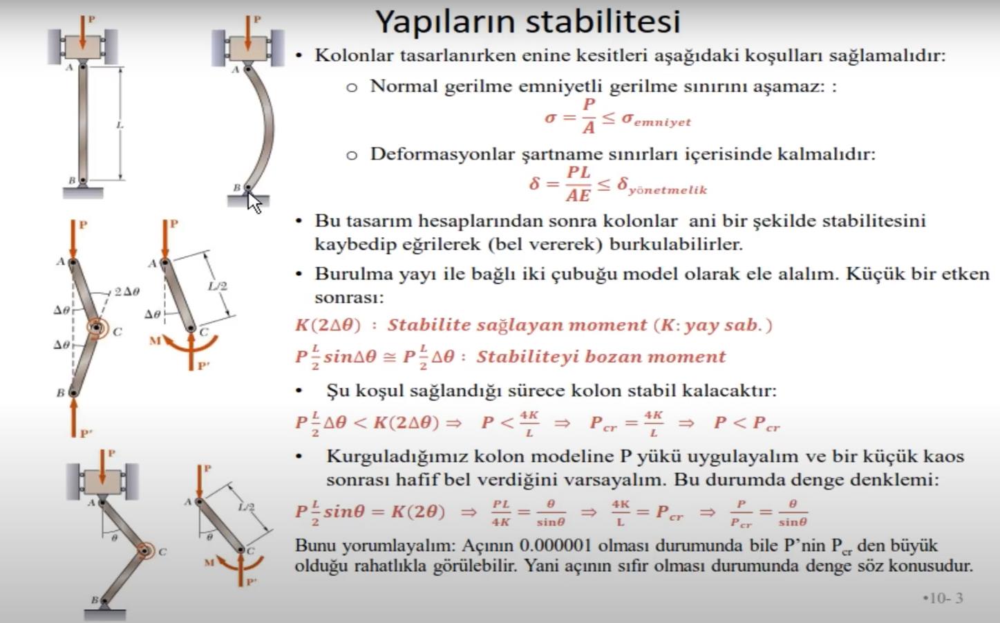
[picture p30: figure]

Şekil 3.2 Yapıların Stabilitesi

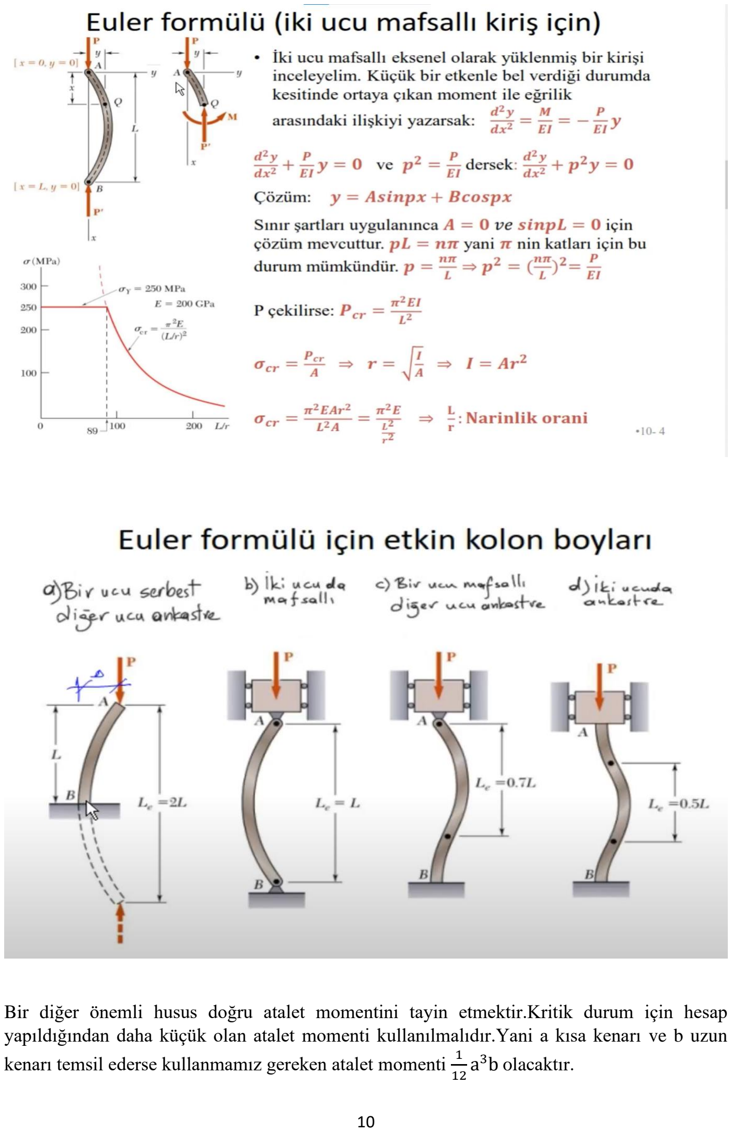
[picture p31: page 12]

Bir diğer önemli husus doğru atalet momentini tayin etmektir.Kritik durum için hesap yapıldığından daha küçük olan atalet momenti kullanılmalıdır.Yani a kısa kenarı ve b uzun kenarı temsil ederse kullanmamız gereken atalet momenti 1
12

a

3b olacaktır.

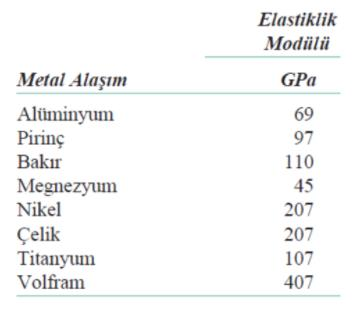
[picture p32: figure]

Bu bilgiler ışığında efektif boyu orjinal boy olarak seçebiliriz.(iki ucu da mafsallı durum). O zaman kritik gerilme :

σkr =

π

2EI
L

2A

=

π

2207x10⁹
a

3b
0.15²x12ab
→ σkr = 7.57x10¹²a

2N/m^2

Kriko kolunda meydana gelen gerilme : (Dikdörtgen kesitli çubuk için inceleniyor)

σg =

P
A

=

646.03
axb N/m^2

Kritik gerilmenin emniyet katsayısına (2) bölümünün gerçek gerilmeden büyük olup olmadığını incelememiz gerekiyor.O halde:

7.57x10¹²a

2
2

≥

646.03
ab

Uzun kenar olan b’yi 20mm , kısa kenar olan a’yı ise 5mm alıp eşitsizliği kontrol edelim:

7.57x10¹²x0.005²
2

≥

646.03
0.005x0.02

→ 94625000 > 6460300 (eşitsizlik sağlanır. )

Sonuç olarak seçimlerimizin uygun olduğunu söyleyebiliriz.Yani kısa kenarı 5 mm uzun

kenarı 20 mm olan dikdörtgen kesitli bir kriko kolu flambajı önlemek için fazlasıyla

yeterlidir.

### 3.3. Teknik Resimler

### 3.3.1. Montaj Resmi

Şekil 3.3 Metal Alaşımların Elastiklik Modülleri

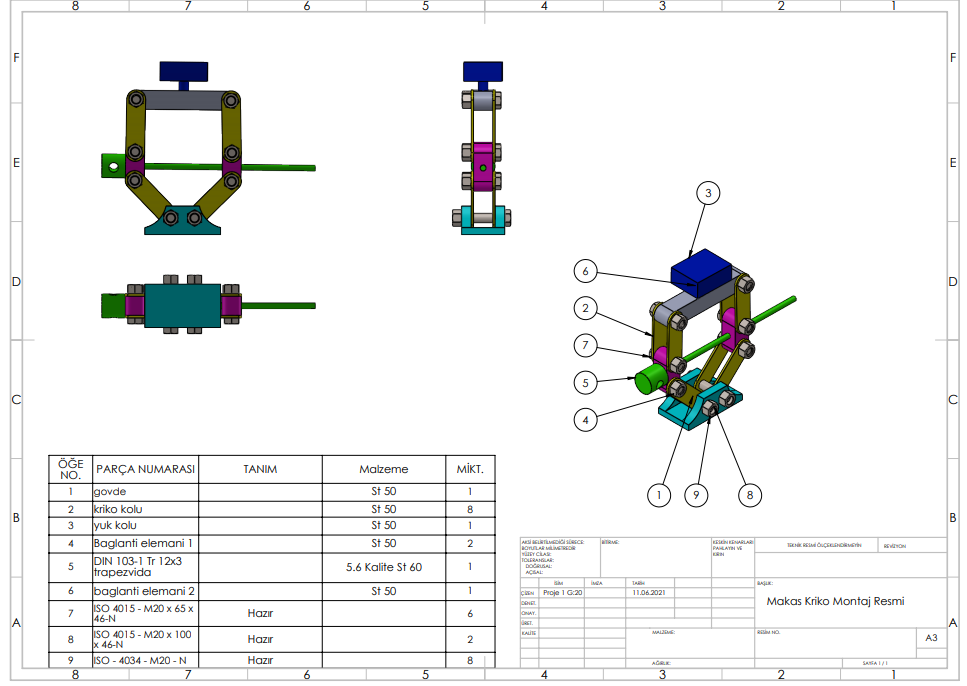
[picture p33: figure]

Şekil 3.4 Krikonun Montaj Resmi

### 3.3.2. İmalat Resimleri

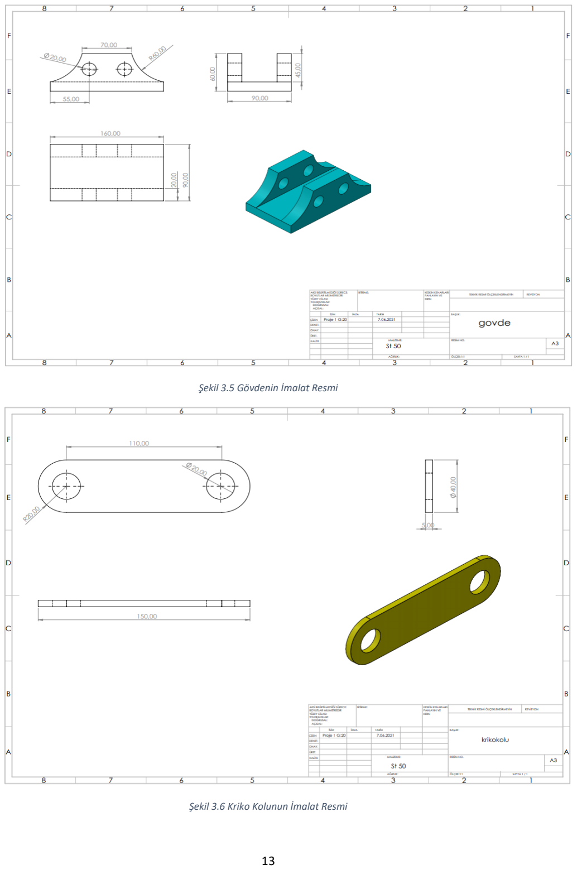
[picture p34: page 15]

Şekil 3.5 Gövdenin İmalat Resmi

Şekil 3.6 Kriko Kolunun İmalat Resmi

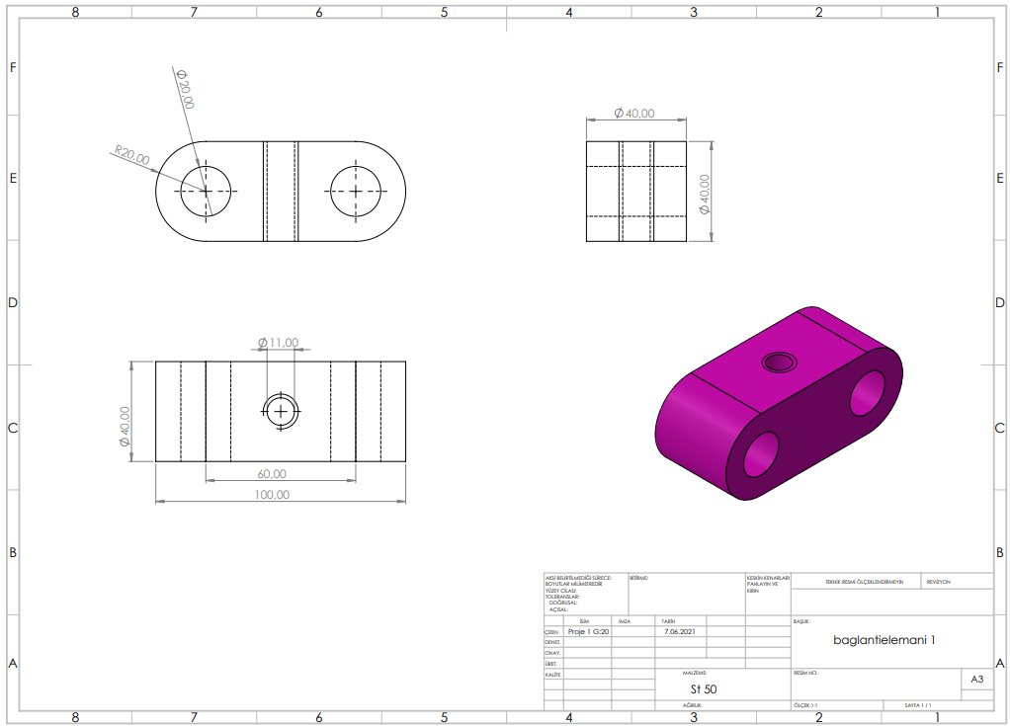
[picture p35: figure]

Şekil 3.7 1 Numaralı Bağlantı Elemanın İmalat Resmi

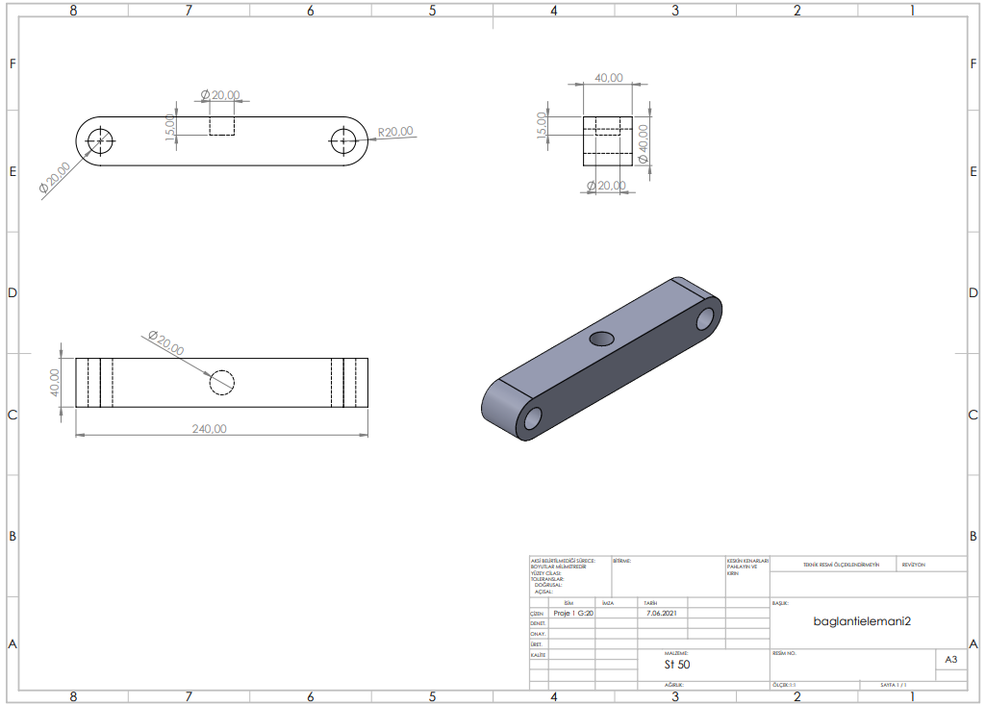
[picture p36: figure]

Şekil 3.8 2 Numaralı Bağlantı Elemanın İmalat Resmi

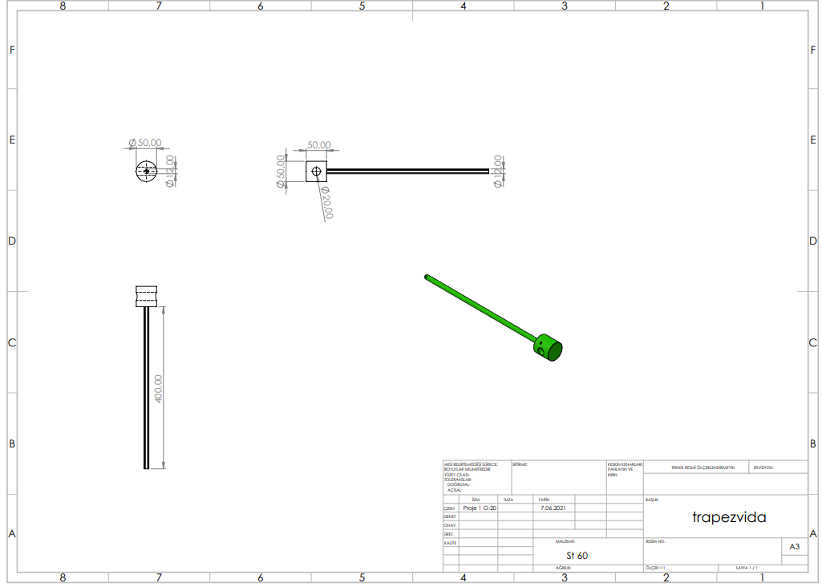
[picture p37: figure]

Şekil 3.9 Trapez Vidanın İmalat Resmi

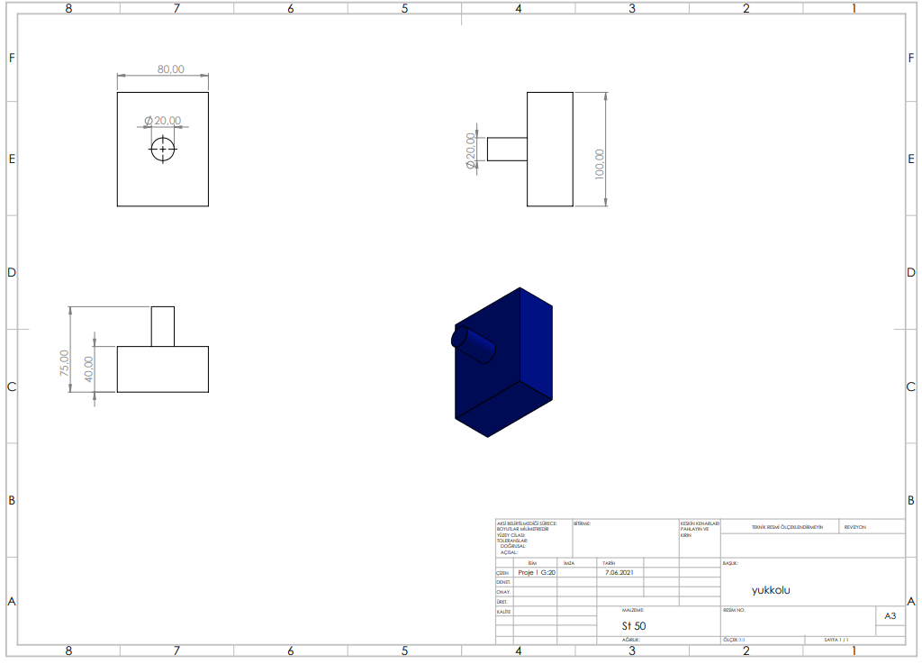
[picture p38: figure]

Şekil 3.10 Yük Kolunun İmalat Resmi

### 3.4 Maliyet Hesabı

Şekil 3.11 Maliyet Tablosu

Hammadde birim Maliyeti
st60 (tl/kg) | st50 (tl/kg)
5,87 | 5,03
Üretilen malzemeler | Ağırlık(kg) | | Malzeme Maliyeti
Gövde | 2,1 | st50 | 10,563
Kriko kolu | 0,23 | st50 | 1,1569
Bağlantı elemanı 1 | 0,64 | st50 | 3,2192
Bağlantı elemanı 2 | 1,34 | st50 | 6,7402
Trapez Vida | 1,12 | st60 | 6,5744
Yük kolu | 1,83 | st50 | 9,2049

Şekil 3.12 İşçi Maliyet Tablosu

Şekil 3.13 Döküm Maliyet Tablosu

Şekil 3.14 Toplam Maliyet Tablosu

### 3.5 Süreç Yönetimi (BPM) ve Hesaplamaları

İş Süreci Yönetiminde Yapay Zekaya Bağlı Tahminleme: Üretim Miktarı Bulma

İş süreçlerinin sürekli optimizasyonu şirketler için hala bir zorluktur. Dijital dönüşüm, daha hızlı değişen iç ve dış çerçeve koşulları, en hızlı teslimat ve en kaliteli mal için yeni müşteri beklentileri ve daha pek çok dönemde şirketler kendi iç süreçlerini en iyi şekilde oluşturmalıdır. Belirsiz zorluklardan birisi de satın alınma miktarıdır. Genel olarak müşterilerin gelecek ay üretilen ürünlerden kaç adet alacağını bilmek imkansızdır. Ancak gerekli makine öğrenmesi algoritmaları ile tahminler yapılabilir. [18].

TL/Ay | TL/Saat
4382 | 18,26

Asgari ücretli işçinin işverene toplam maliyeti Elektrik Maliyeti

Güç (kw) | 15
1 kw Saatlik Fiyatı | 0,59
Saatlik maliyet (TL) | 8,85
Bakım Maliyeti | 0,02 tl/operasyon
Amortisman Maliyeti
Makine maliyeti (TL) | 350000
Ekonomik Ömrü (Yıl) | 20
Yıllık Amortisman Tutarı (TL/Yıl | 17500
Saatlik Amortisman Tutarı (TL) | 2,0

Döküm makinesinin maliyeti

Kriko üretim operasyonun 20 dakika süreceğini varsayarsak
Toplam malzeme maliyeti | 37,4586
Toplam işçi maliyeti | 2 işçi için | 12,172
Toplam operasyon maliyeti | 6 makine için | 29,806
Toplam Maliyet | 79,437

Elimizde belirli boyutlarda üretime geçmeye hazır krikolar ve parçaları bulunmakta. Bu parçaların ne kadar üretilmesi gerektiğini iş sürecimizde tasarlayacağız ve optimum üretim sayısını BPM (Business Process Management) döngümüz sonunda bulacağız. Her döngü sonrası geri-besleme mekanizması sayesinde gerçek verilerimiz çoğalacak. Çoğalan veriler ile daha iyi tahmin yürütme algoritmaları geliştirilecek. Bu şekilde her döngü sonunda tahmin modellerimiz daha da optimize olacak.

BPM döngüsünde Tahmine Dayalı İş Süreci İzlemenin, bir iş sürecinin çalışan örneklerinde ne olacağını tahmin etmek için veri madenciliği, makine öğrenimi ve diğer tahmin tekniklerinin uygulanmasıyla ilgili olduğunu söylemiştik. İzlemeyi gerçekleştirmek için trends.google.com sitesinden gerekli ilgilerin veri setlerini elde ettik. Bu veri setleri ile oluşturacağımız AI( Yapay Zeka) algoritmamızı eğiteceğiz. Eğittiğimiz bu algoritma ile gelecekteki ilgilerin grafiğini tahmin edeceğiz. Tahmin ettiğimiz veriler ışığında ne kadar adet krikoyu ne kadar süre içerisinde üretmemiz gerektiğini bulacağız. Gün geçtikçe verilerimiz çoğaldığından daha modelimizi eğitmemiz daha olanaklı olacaktır.

Verilerimizin görselleştirilmiş hali şu şekildedir[19].:

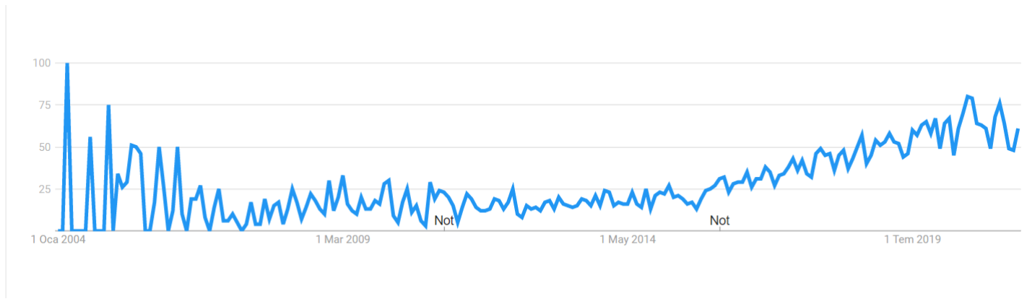
[picture p39: figure]

Şekil 3.15 Satın Alma Verileri Grafiği

Öncelikle Regresyon modelimizi kurmak için Python adlı yazılım dilinden yararlandık. Gerekli kütüphaneleri kurduktan sonra elimizdeki verilerle modelimizi eğittik. Zaman doğrusal olarak arttığı için X eksenine yani bağımsız değişkenimize zamanımızın ölçeklenmiş halini koyduk. Y eksenimizde yani bağımlı değişkenimiz ise satın alınma miktarı idi.

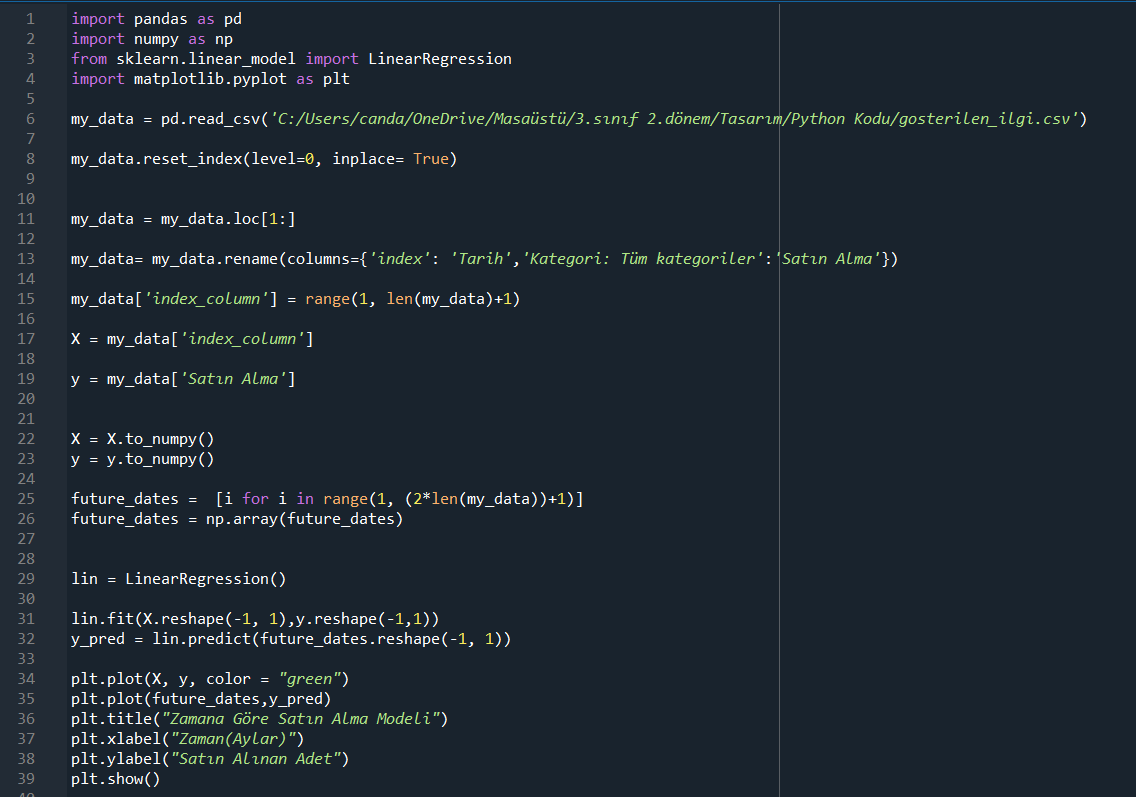
[picture p40: figure]

Şekil 3.16 Yazılım Kodu

Yukarıda bulunan 40 satırlık Python kodu ile modelimizi oluşturup görselleştirdik.

Çıktı olarak regresyon modelimiz şu şekildedir:

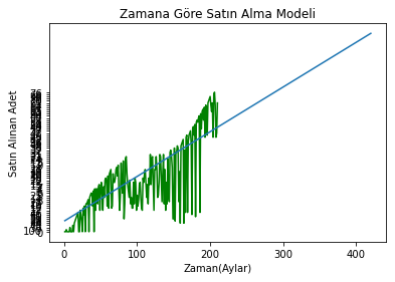
[picture p41: figure]

Şekil 3.17 Regresyon Sonuçları Grafiği

Yukarıdaki tahmin edilmiş verilere bakılarak ne kadar ürün üretilmesi gerektiği gelecek ay için hesaplanabilir. Elde edilen veriler çoğaldıkça modelimizi eğitmemiz daha kolay olur. Bu sebeple her bir BPM Life Cycle için elde ettiğimiz tahminler daha optimize olur.

### 4. ÇEVRESEL ETKİ DEĞERLENDİRMESİ

Çalışma ortamımız günümüz koşullarında genel olarak kullanılan üretim ortamıdır. Atölye ortamları genel itibari ile çevre için olumlu ve olumsuz sonuçlar doğurmaktadır. Olumlu sonuçlara örnek olarak buradan çıkan atıkların sistematik bir şekilde geri dönüşüme kazandırıldığından bahsedebiliriz. İşçilerin ve mühendislerin de ekstra dikkati ile atık olarak çevrede iz bırakacak maddeler geri dönüşüme kazandırılır. Olumsuz etkileri ise bazı geri dönüştürülemeyen atıklar (atölye bacasından çıkan duman) çevreye CO2 salınımı yaptığı için küresel ısınmaya sebebiyet vermektedir. Bunu engellemek için ise ekstra maliyetli olarak üretim ortamımızdaki bacalara filtre takılabilir.

### 5. SONUÇLAR VE DEĞERLENDİRME

-Proje genel olarak tanımlandı.

-Kriko ve Süreç Yönetimi ile ilgili araştırmalar yapıldı.

-Gerekli mühendislik hesapları yapıldı.

-Hareket cıvatası boyutlandırıldı.

-Kriko kollarının burkulma hesaplarına göre geometrileri belirlendi

-Gerekli teknik resimler çizildi.

-Maliyet hesapları yapıldı.

-BPM(Business Process Management) döngüsü Yapay Zeka kullanılarak gerçekleştirildi ve izlendi.

-Çevresel açıdan risk değerlendirmesi yapıldı.

KAYNAKÇA

[1] Dudgeon, R., Dudgeon's Patent Portable Hydraulic Press, Or Lifting Jack: For Raising Heavy Weights, Stone, Timber, Boilers, Locomotives, Railway Carriages, 1 Ocak 1853
[2] Chetan S.Dhamak, D.S.Bajaj, V.S.Aher, “Design and Optimization Scissor Jack”,Amrutvahini College of Engineering, Department of Mechanical Engineering, 2016
[3] Makine Teknolojisi – Kaldırma ve Taşıma Araçları www.megep.meb.gov.tr/mte_program_modul/moduller_pdf/Kald%C4%B1rma%20Ve%20Ta %C5%9F%C4%B1ma%20Ara%C3%A7lar%C4%B1.pdf (http://www.megep.meb.gov.tr/mte_program_modul/moduller_pdf/Kald%C4%B1rma%20Ve%20Ta%C5%9F%C4%B1ma%20Ara%C3%A7lar%C4%B1.pdf) [Alıntı Tarihi 6 Haziran 2021]
[4] Bariskan M, “Design And FEM Analysis of Scissor Jack”, City College of New York, Mechanical Engineering Department, 2014
[6] Shigley J, Eggert R.J, Standard Handbook Of Machine Design, 2004
[7] Ferhat D, Makine Elemanları-1 Ders Notu, İstanbul, 2014
[8] Chetan S.Dhamak, D.S.Bajaj, V.S.Aher, “Design and Optimization Scissor Jack”,Amrutvahini College of Engineering, Department of Mechanical Engineering, 2016
[8] M. Kiyak,Yıldız Teknik Üniversitesi, İmalat Yöntemleri 2 Ders notları

[9]Academia.edu/6167889/Modification_of_the_Existing_Design_of_a_Car_Jack.[Alıntı Tarihi: 6 Haziran 2021]

[10] http://scholarsresearchlibrary.com/EJAESR-vol1-iss4/EJAESR-2012-1-4-167- 172.pdf

[Alıntı Tarihi: 6 Haziran 2021]

[11] http://www.ehs.utoronto.ca/Assets/ehs+Digital+Assets/ehs3/documents/Lifting+ Devices+Standard.pdf [Alıntı Tarihi : 6 Haziran 2021]
[12] https://www.slideshare.net/ssasankbabu/mergeddocument-52547137 [Alıntı Tarihi 6 Haziran 2021]
[13] Jeston, John; Nelis, Johan (21 January 2014). Business Process Management. (https://books.google.com/books?id=8Q6pAgAAQBAJ&q=business+process+management&pg=PP1) Routledge. ISBN (https://en.wikipedia.org/wiki/ISBN_(identifier)) 9781136172984. (https://en.wikipedia.org/wiki/Special:BookSources/9781136172984)
[14] Theodore Panagacos (25 September 2012). The Ultimate Guide to Business Process Management: Everything You Need to Know and How to Apply It to Your Organization. (https://books.google.com/books?id=AyCQMQEACAAJ) CreateSpace Independent Publishing Platform. pp. 6–7. ISBN (https://en.wikipedia.org/wiki/ISBN_(identifier)) 978-1-4774-8613-9. (https://en.wikipedia.org/wiki/Special:BookSources/978-1-4774-8613-9)
[15] Palmer, Nathaniel. "What Is BPM". (https://bpm.com/what-is-bpm) bpm.com. Retrieved 30 September 2017.
[16] Franz Bayer, Harald Kühn (ed.): "Prozessmanagement für Experten - Impulse für aktuelle und wiederkehrende Themen", Springer-lVerlag Berlin Heidelberg 2013
[17] Cabanillas, C.; Di Ciccio, C.; Mendling, J.; Baumgrass, A. (2014). Predictive Task Monitoring for Business Processes. Proceedings of the International Conference on Business Process Management (BPM). Lecture Notes in Computer Science. 8659. pp. 424–
432. doi: (https://en.wikipedia.org/wiki/Doi_(identifier))10.1007/978-3-319-10172-9_31. (https://doi.org/10.1007%2F978-3-319-10172-9_31) ISBN (https://en.wikipedia.org/wiki/ISBN_(identifier)) 978-3-319-10171-2. (https://en.wikipedia.org/wiki/Special:BookSources/978-3-319-10171-2)

[18] Daniel Paschek1,*, Caius Tudor Luminosu1 , and Anca Draghici1 1Politehnica University Timisoara, Management Faculty, 300191, Timisoara, Romania, Automated business process management – in times of digital transformation using machine learning or artificial intelligence
[19] https://trends.google.com/trends/ [Alıntı Tarihi: 6 Haziran 2021]
