hkn55/Kriko-/(list of files, cad)

Other CAD files:
Hakan Aktaş 18065037 screwjack.dwg
